naturalhazardscience/groundlark/hw/burrowlark-usb/boards/groundlark-field-head/preview/groundlark-field-head-01-usb-power-page-01.png

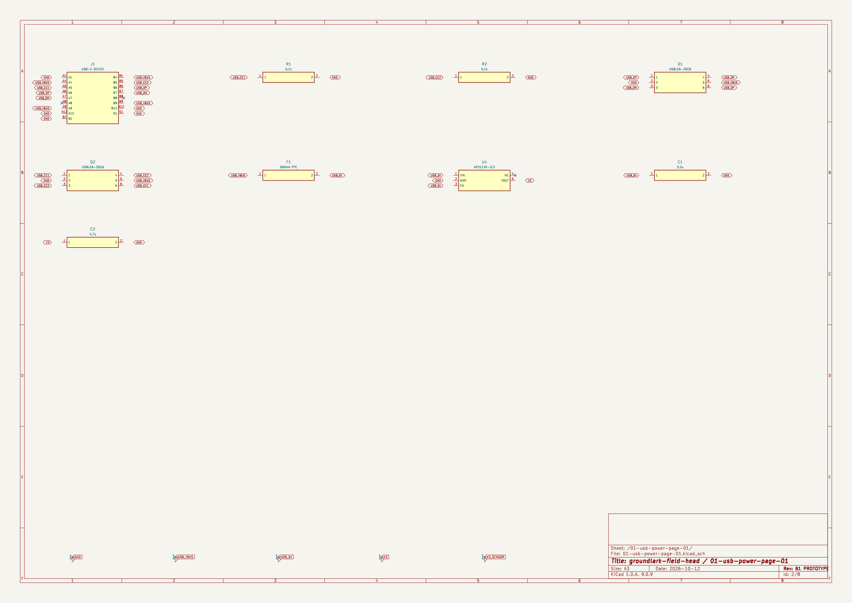
hw/burrowlark-usb/boards/groundlark-field-head/preview/groundlark-field-head-01-usb-power-page-01.png
