naturalhazardscience/groundlark/hw/burrowlark-usb/boards/groundlark-field-head/preview/groundlark-field-head-02-controller-page-01.png

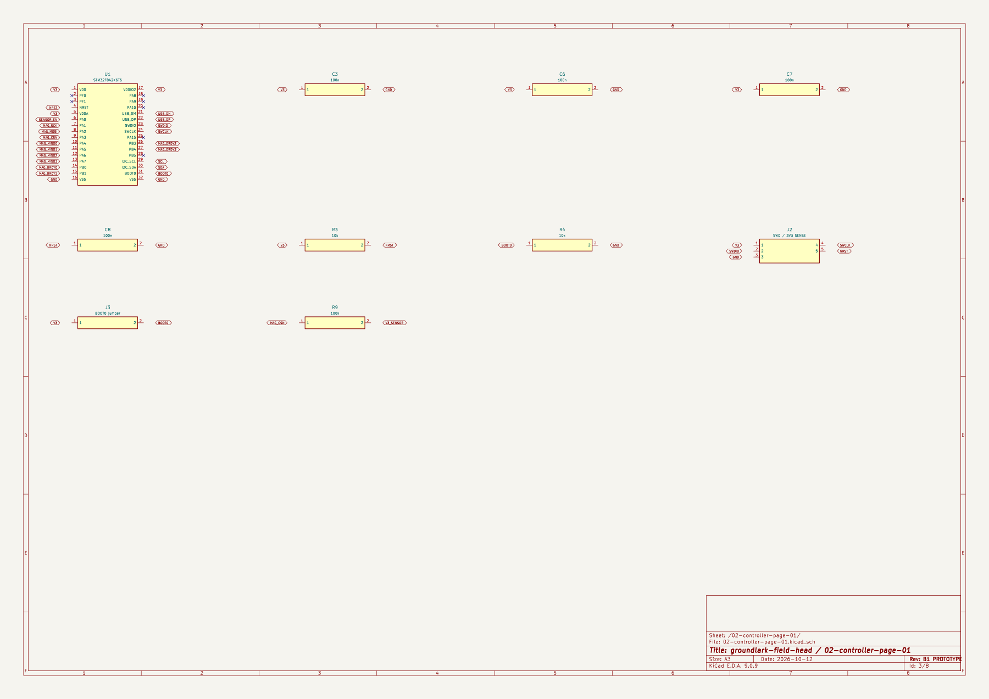
hw/burrowlark-usb/boards/groundlark-field-head/preview/groundlark-field-head-02-controller-page-01.png
