naturalhazardscience/groundlark/hw/burrowlark-usb/boards/groundlark-field-head/preview/groundlark-field-head-03-magnetometer-0-page-01.png

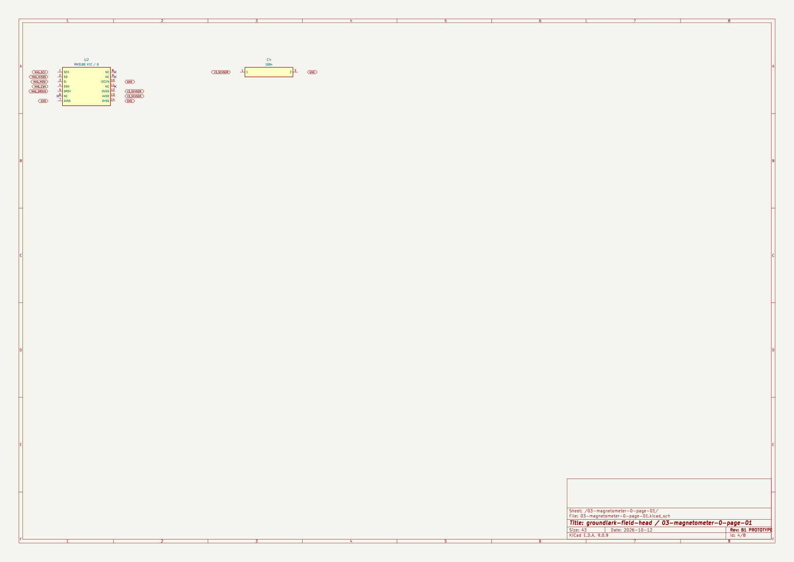
hw/burrowlark-usb/boards/groundlark-field-head/preview/groundlark-field-head-03-magnetometer-0-page-01.png
