naturalhazardscience/groundlark/hw/burrowlark-usb/boards/groundlark-field-head/preview/groundlark-field-head.png

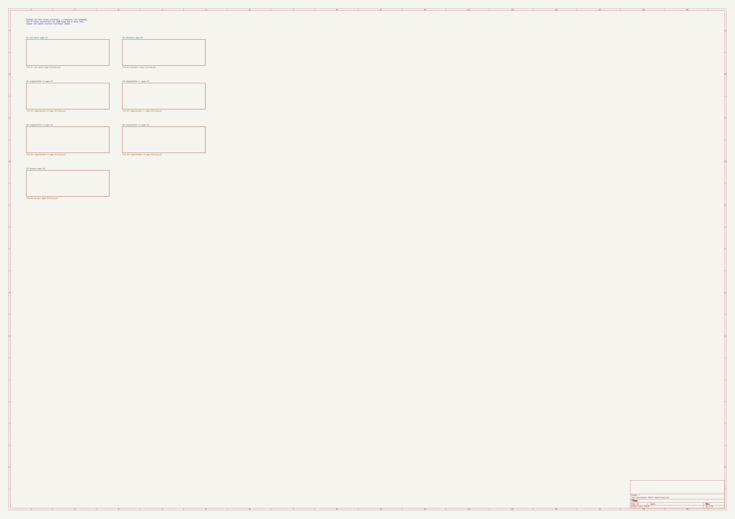
hw/burrowlark-usb/boards/groundlark-field-head/preview/groundlark-field-head.png
