naturalhazardscience/groundlark/hw/burrowlark-usb/boards/groundlark-field-head/preview/layout.png

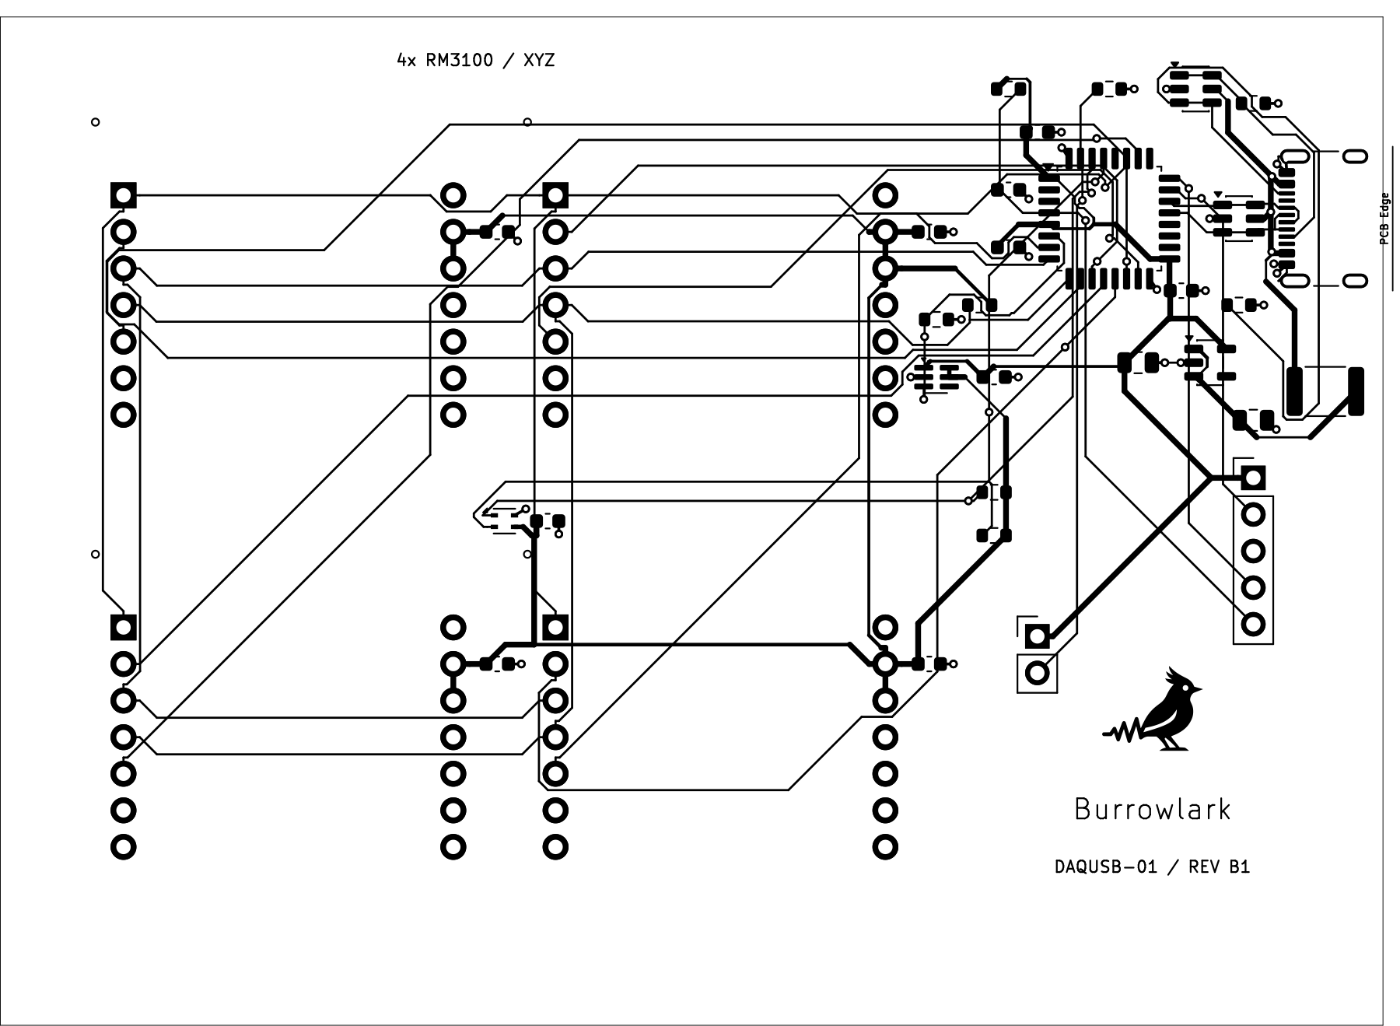
hw/burrowlark-usb/boards/groundlark-field-head/preview/layout.png
