naturalhazardscience/groundlark/hw/groundlark-fpga-hat/boards/groundlark-daqhat-01/3d-bottom.png

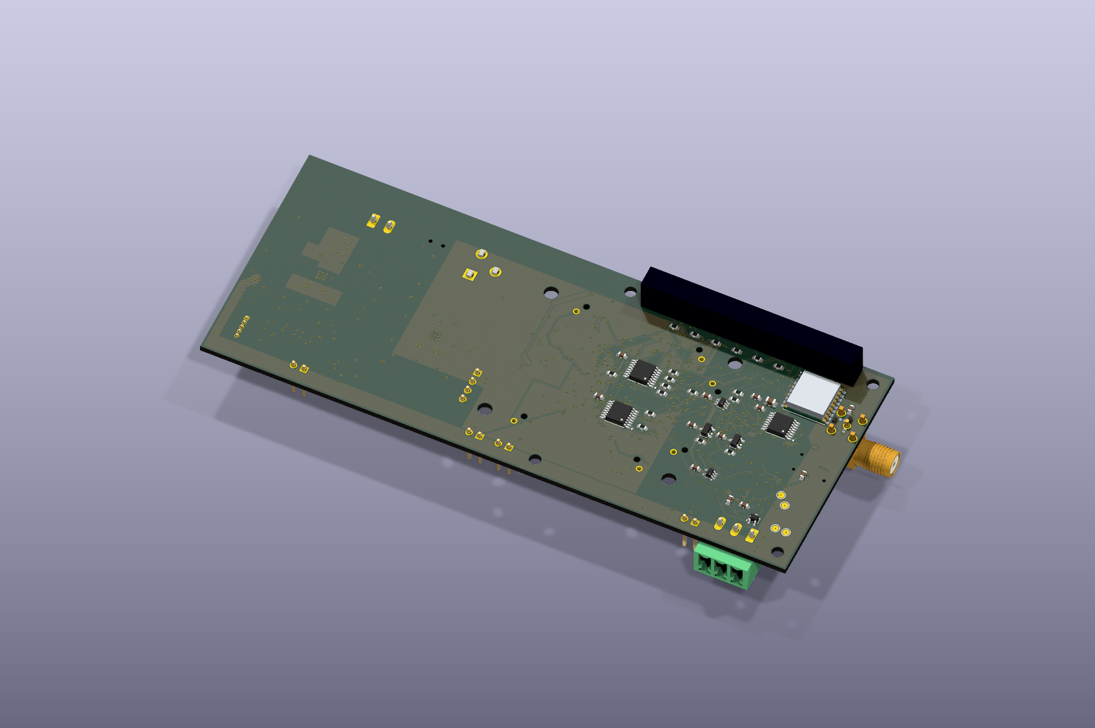
hw/groundlark-fpga-hat/boards/groundlark-daqhat-01/3d-bottom.png
