naturalhazardscience/groundlark/hw/groundlark-fpga-hat/boards/groundlark-daqhat-01/3d.png

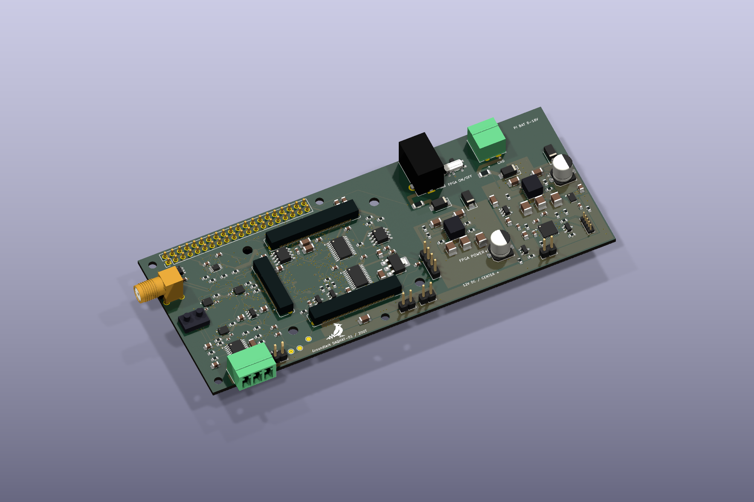
hw/groundlark-fpga-hat/boards/groundlark-daqhat-01/3d.png
