naturalhazardscience/groundlark/hw/groundlark-fpga-hat/boards/groundlark-daqhat-01/pi-trenz-stack-concept.png

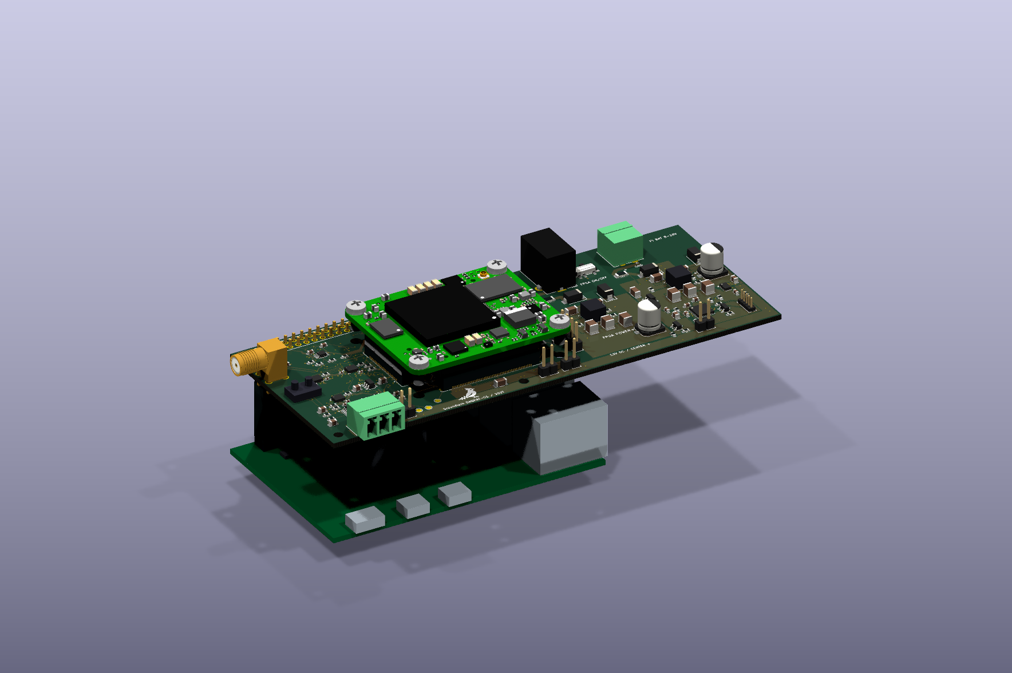
hw/groundlark-fpga-hat/boards/groundlark-daqhat-01/pi-trenz-stack-concept.png
