naturalhazardscience/groundlark/hw/groundlark-fpga-hat/boards/groundlark-daqhat-01/stack-exploded.png

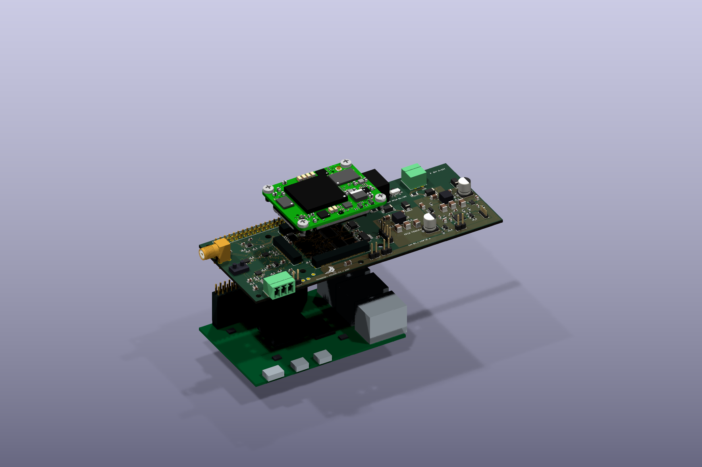
hw/groundlark-fpga-hat/boards/groundlark-daqhat-01/stack-exploded.png
