naturalhazardscience/groundlark/hw/groundlark-fpga-hat/boards/groundlark-daqhat-01/stack-service-envelopes.png

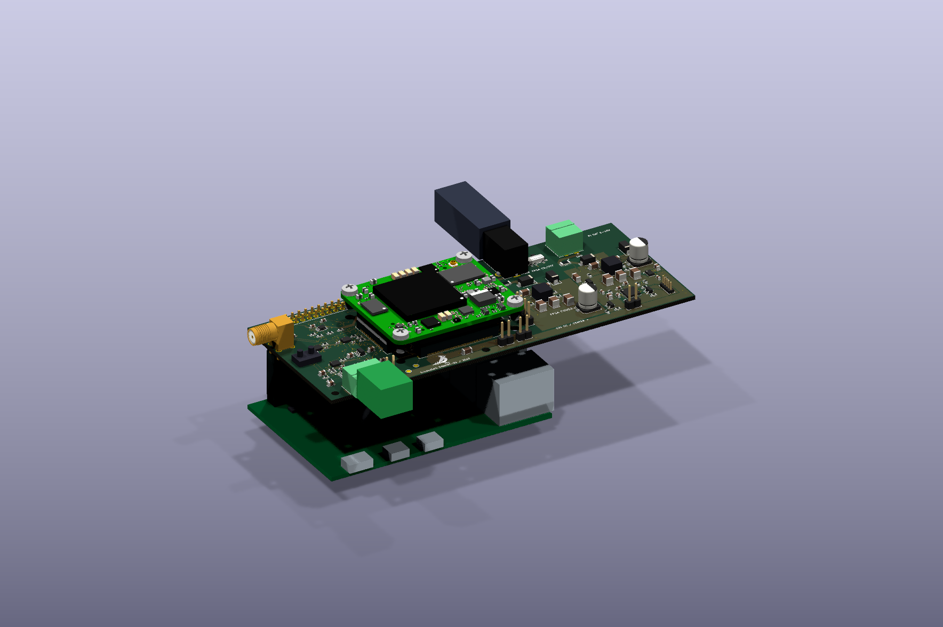
hw/groundlark-fpga-hat/boards/groundlark-daqhat-01/stack-service-envelopes.png
