naturalhazardscience/groundlark/hw/groundlark-fpga-hat/boards/groundlark-daqhat-01/trenz-mounted.png

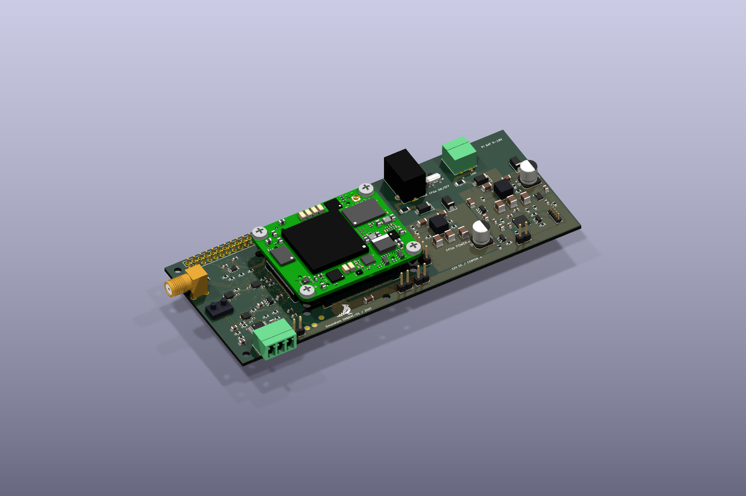
hw/groundlark-fpga-hat/boards/groundlark-daqhat-01/trenz-mounted.png
