naturalhazardscience/groundlark/hw/groundlark-fpga-hat/boards/groundlark-daqhat-01/bom.csv

Reference | Value | MPN | Footprint | DNP | Note
J1 | Raspberry Pi 40-pin | Samtec ESQ-120-23-G-D | Connector_PinHeader_2.54mm__PinHeader_2x20_P2.54mm_Vertical | False | Header land pattern matches bottom mounted socket top-view numbering; tall stack, check Pi 4/5 cooler clearance.
U1 | 24LC32A | 24LC32A-I/SN | Package_SO__SOIC-8_3.9x4.9mm_P1.27mm | False
R1 | 3.9k | RC0603FR-073K9L | Resistor_SMD__R_0603_1608Metric | False
R2 | 3.9k | RC0603FR-073K9L | Resistor_SMD__R_0603_1608Metric | False
R3 | 1k | RC0603FR-071KL | Resistor_SMD__R_0603_1608Metric | False
JP1 | EEPROM write enable | EEPROM write enable | Connector_PinHeader_2.54mm__PinHeader_1x02_P2.54mm_Vertical | False | Fit shunt only while programming ID EEPROM.
C1 | 100n | GRM188R71H104KA93D | Capacitor_SMD__C_0603_1608Metric | False
C2 | 10u | GRM21BR61A106KE19L | Capacitor_SMD__C_0805_2012Metric | False
C3 | 10u | GRM21BR61A106KE19L | Capacitor_SMD__C_0805_2012Metric | False
U11 | LSM6DSOTR | LSM6DSOTR | Package_LGA__LGA-14_3x2.5mm_P0.5mm_LayoutBorder3x4y | False
C12 | 100n | GRM155R71C104KA88D | Capacitor_SMD__C_0402_1005Metric | False
C13 | 100n | GRM155R71C104KA88D | Capacitor_SMD__C_0402_1005Metric | False
R11 | 10k | RC0603FR-0710KL | Resistor_SMD__R_0603_1608Metric | False
U12 | LSM6DSOTR | LSM6DSOTR | Package_LGA__LGA-14_3x2.5mm_P0.5mm_LayoutBorder3x4y | False
C14 | 100n | GRM155R71C104KA88D | Capacitor_SMD__C_0402_1005Metric | False
C15 | 100n | GRM155R71C104KA88D | Capacitor_SMD__C_0402_1005Metric | False
R12 | 10k | RC0603FR-0710KL | Resistor_SMD__R_0603_1608Metric | False
U13 | LSM6DSOTR | LSM6DSOTR | Package_LGA__LGA-14_3x2.5mm_P0.5mm_LayoutBorder3x4y | False
C16 | 100n | GRM155R71C104KA88D | Capacitor_SMD__C_0402_1005Metric | False
C17 | 100n | GRM155R71C104KA88D | Capacitor_SMD__C_0402_1005Metric | False
R13 | 10k | RC0603FR-0710KL | Resistor_SMD__R_0603_1608Metric | False
J4 | FPGA test UART/reset | FPGA UART service ONLY | Connector_PinHeader_2.54mm__PinHeader_1x04_P2.54mm_Vertical | False | Test points for assembled module UART and active-low reset; do not connect a second driving host.
H1 | M2.5 NPTH | M2.5 NPTH | MountingHole__MountingHole_2.7mm_M2.5 | False | Nonmagnetic standoffs.
H2 | M2.5 NPTH | M2.5 NPTH | MountingHole__MountingHole_2.7mm_M2.5 | False | Nonmagnetic standoffs.
H3 | M2.5 NPTH | M2.5 NPTH | MountingHole__MountingHole_2.7mm_M2.5 | False | Nonmagnetic standoffs.
H4 | M2.5 NPTH | M2.5 NPTH | MountingHole__MountingHole_2.7mm_M2.5 | False | Nonmagnetic standoffs.
U40 | TLV1117LV33DCYR | TLV1117LV33DCYR | Package_TO_SOT_SMD__SOT-223-3_TabPin2 | False
C40 | 10u | GRM21BR61A106KE19L | Capacitor_SMD__C_0805_2012Metric | False
C41 | 100n | GRM188R71H104KA93D | Capacitor_SMD__C_0603_1608Metric | False
C42 | 22u | GRM31CR61A226KE19L | Capacitor_SMD__C_1206_3216Metric | False
C43 | 100n | GRM188R71H104KA93D | Capacitor_SMD__C_0603_1608Metric | False
U41 | SN74LVC8T245PWR | SN74LVC8T245PWR | Package_SO__TSSOP-24_4.4x7.8mm_P0.65mm | False
U42 | SN74LVC8T245PWR | SN74LVC8T245PWR | Package_SO__TSSOP-24_4.4x7.8mm_P0.65mm | False
C44 | 100n | GRM188R71H104KA93D | Capacitor_SMD__C_0603_1608Metric | False
C45 | 100n | GRM188R71H104KA93D | Capacitor_SMD__C_0603_1608Metric | False
C46 | 100n | GRM188R71H104KA93D | Capacitor_SMD__C_0603_1608Metric | False
C47 | 100n | GRM188R71H104KA93D | Capacitor_SMD__C_0603_1608Metric | False
R50 | 10k | RC0603FR-0710KL | Resistor_SMD__R_0603_1608Metric | False
R51 | 100k | RC0603FR-07100KL | Resistor_SMD__R_0603_1608Metric | False
U43 | ISO1640BDR | ISO1640BDR | Package_SO__SOIC-8_3.9x4.9mm_P1.27mm | False | Power-domain isolation only: grounds are joined. Side-1 VOL max 0.71V requires host VIL >=0.8V; verify Pi revision.
C48 | 100n | GRM188R71H104KA93D | Capacitor_SMD__C_0603_1608Metric | False
C49 | 100n | GRM188R71H104KA93D | Capacitor_SMD__C_0603_1608Metric | False
R52 | 4.7k | RC0603FR-074K7L | Resistor_SMD__R_0603_1608Metric | False
R53 | 4.7k | RC0603FR-074K7L | Resistor_SMD__R_0603_1608Metric | False
TP1 | SENS_3V3 | SENS_3V3 | TestPoint__TestPoint_Pad_D1.5mm | False
TP2 | GND | GND | TestPoint__TestPoint_Pad_D1.5mm | False
TP4 | SENSOR_OE_N | SENSOR_OE_N | TestPoint__TestPoint_Pad_D1.5mm | False
U51 | TXU0202DCUR | TXU0202DCUR | Package_SO__VSSOP-8_2.3x2mm_P0.5mm | False
C75 | 100n | GRM188R71H104KA93D | Capacitor_SMD__C_0603_1608Metric | False
C76 | 100n | GRM188R71H104KA93D | Capacitor_SMD__C_0603_1608Metric | False
R61 | 47 | RC0603FR-0747RL | Resistor_SMD__R_0603_1608Metric | False
R62 | 100k | RC0603FR-07100KL | Resistor_SMD__R_0603_1608Metric | False
R63 | 10k | RC0603FR-0710KL | Resistor_SMD__R_0603_1608Metric | False
U52 | TLV803EA30DBZR | TLV803EA30DBZR | Package_TO_SOT_SMD__SOT-23 | False | 3.0V falling threshold, 200ms nominal release delay; open-drain output.
C77 | 100n | GRM188R71H104KA93D | Capacitor_SMD__C_0603_1608Metric | False
R64 | 10k | RC0603FR-0710KL | Resistor_SMD__R_0603_1608Metric | False
Q1 | 2N7002 | 2N7002 | Package_TO_SOT_SMD__SOT-23 | False | Pi GPIO17 HIGH asserts chip reset; does not drive a live voltage into unpowered chip.
R65 | 1k | RC0603FR-071KL | Resistor_SMD__R_0603_1608Metric | False
R66 | 100k | RC0603FR-07100KL | Resistor_SMD__R_0603_1608Metric | False
J80 | LSHM-150-04.0-L-DV-A-S-K-TR | LSHM-150-04.0-L-DV-A-S-K-TR | TZ_TZ100 | False | Mates JM1; opposite parity; 8 mm board surface gap
J81 | LSHM-150-04.0-L-DV-A-S-K-TR | LSHM-150-04.0-L-DV-A-S-K-TR | TZ_TZ100 | False | Mates JM2; opposite parity; 8 mm board surface gap
J82 | LSHM-130-04.0-L-DV-A-S-K-TR | LSHM-130-04.0-L-DV-A-S-K-TR | TZ_TZ60 | False | Mates JM3; opposite parity; 8 mm board surface gap
JP80 | TSW-102-07-G-S | TSW-102-07-G-S | TZ_TZ_JP | False | Fit shunt to DISABLE module; open enables on-board sequence
JP81 | TSW-102-07-G-S | TSW-102-07-G-S | TZ_TZ_JP | False | Fit shunt to request module configuration reset
R80 | 10k | RC0603FR-0710KL | Resistor_SMD__R_0603_1608Metric | False | FPGA JTAG selection / spare CPLD control idle pull-down
R81 | 10k | RC0603FR-0710KL | Resistor_SMD__R_0603_1608Metric | False | FPGA JTAG selection / spare CPLD control idle pull-down
C80 | 22u | GRM31CR61A226KE19L | Capacitor_SMD__C_1206_3216Metric | False | Carrier local decoupling; module contains core decoupling
C81 | 22u | GRM31CR61A226KE19L | Capacitor_SMD__C_1206_3216Metric | False | Carrier local decoupling; module contains core decoupling
C82 | 22u | GRM31CR61A226KE19L | Capacitor_SMD__C_1206_3216Metric | False | Carrier local decoupling; module contains core decoupling
C83 | 100n | GRM188R71H104KA93D | Capacitor_SMD__C_0603_1608Metric | False | Carrier local decoupling; module contains core decoupling
C84 | 4.7u | GRM21BR71A475KA73L | Capacitor_SMD__C_0805_2012Metric | False | Carrier local decoupling; module contains core decoupling
C85 | 4.7u | GRM21BR71A475KA73L | Capacitor_SMD__C_0805_2012Metric | False | Carrier local decoupling; module contains core decoupling
H80 | M3 / 8 mm spacer | M3 / 8 mm spacer | TZ_TZ_HOLE | False
H81 | M3 / 8 mm spacer | M3 / 8 mm spacer | TZ_TZ_HOLE | False
H82 | M3 / 8 mm spacer | M3 / 8 mm spacer | TZ_TZ_HOLE | False
H83 | M3 / 8 mm spacer | M3 / 8 mm spacer | TZ_TZ_HOLE | False
U22 | ADS122C04 | ADS122C04IPWR | Package_SO__TSSOP-16_4.4x5mm_P0.65mm | False | I2C 0x40; internal 2.048V reference, gain 64, normal 330 SPS; unused analog/reference inputs open per TI.
J90 | GEO + / - / SHIELD | 1803280 | Connector_Phoenix_MC__PhoenixContact_MC_1,5_3-G-3.81_1x03_P3.81mm_Horizontal | False | Horizontal outward entry (+Y). 1 positive, 2 negative, 3 cable shield. Mate Phoenix 1803581. Never connect power.
D90 | TPD2E2U06 | TPD2E2U06QDCKRQ1 | Package_TO_SOT_SMD__SOT-323_SC-70 | False | Connector ESD suppression only; not lightning protection.
R90 | 1k | RC0603FR-071KL | Resistor_SMD__R_0603_1608Metric | False | Matched series input filter / current limiting.
R91 | 1k | RC0603FR-071KL | Resistor_SMD__R_0603_1608Metric | False
C90 | 100n C0G | C3216C0G1H104J160AA | Capacitor_SMD__C_1206_3216Metric | False | C0G differential filter; no piezoelectric X7R on signal path.
C91 | 1n C0G | C0603C102J5GACTU | Capacitor_SMD__C_0603_1608Metric | False
C92 | 1n C0G | C0603C102J5GACTU | Capacitor_SMD__C_0603_1608Metric | False
R92 | 1M | RC0603FR-071ML | Resistor_SMD__R_0603_1608Metric | False
R93 | 1M | RC0603FR-071ML | Resistor_SMD__R_0603_1608Metric | False
R94 | 10k | RC0603FR-0710KL | Resistor_SMD__R_0603_1608Metric | False
R95 | 10k | RC0603FR-0710KL | Resistor_SMD__R_0603_1608Metric | False
C93 | 10u | GRM21BR61A106KE19L | Capacitor_SMD__C_0805_2012Metric | False | Filtered mid-supply; sensor has no excitation current source.
R96 | 22 | RC0603FR-0722RL | Resistor_SMD__R_0603_1608Metric | False
C94 | 10u | GRM21BR61A106KE19L | Capacitor_SMD__C_0805_2012Metric | False
C95 | 100n | GRM188R71H104KA93D | Capacitor_SMD__C_0603_1608Metric | False
C96 | 100n | GRM188R71H104KA93D | Capacitor_SMD__C_0603_1608Metric | False
R97 | 10k | RC0603FR-0710KL | Resistor_SMD__R_0603_1608Metric | False | Open-drain DRDY pullup; existing U42 return buffer to BCM4.
U100 | TMUX1574PWR | TMUX1574PWR | Package_SO__TSSOP-16_4.4x5mm_P0.65mm | False | SEL=0 application, SEL=1 native JTAG; EN high isolates; FPGA-powered with power-off protection.
U101 | TMUX1574PWR | TMUX1574PWR | Package_SO__TSSOP-16_4.4x5mm_P0.65mm | False | S1B/S2B deliberately open parking paths: isolate CS/DQ3 in JTAG. Unused complete channels grounded.
U102 | TCA9534PWR | TCA9534PWR | Package_SO__TSSOP-16_4.4x5mm_P0.65mm | False | I2C 0x20. Write output 0 before config 0xFC. P2-P7 remain grounded inputs; INT unused. Pi header supplies I2C pullups.
U103 | SN74LVC1G10DCKR | SN74LVC1G10DCKR | Package_TO_SOT_SMD__SOT-363_SC-70-6 | False | Disable unless request AND both independent rail supervisors are high; inputs tolerate an unpowered gate.
U104 | TLV809EA30DBZR | TLV809EA30DBZR | Package_TO_SOT_SMD__SOT-23 | False | 3.0 V threshold, 200 ms nominal release, push-pull. Separate from application reset.
U105 | TLV809EA30DBZR | TLV809EA30DBZR | Package_TO_SOT_SMD__SOT-23 | False | 3.0 V threshold, 200 ms nominal release, push-pull. Separate from application reset.
C100 | 100n | GRM188R71H104KA93D | Capacitor_SMD__C_0603_1608Metric | False
C101 | 100n | GRM188R71H104KA93D | Capacitor_SMD__C_0603_1608Metric | False
C102 | 100n | GRM188R71H104KA93D | Capacitor_SMD__C_0603_1608Metric | False
C103 | 100n | GRM188R71H104KA93D | Capacitor_SMD__C_0603_1608Metric | False
C104 | 100n | GRM188R71H104KA93D | Capacitor_SMD__C_0603_1608Metric | False
C105 | 100n | GRM188R71H104KA93D | Capacitor_SMD__C_0603_1608Metric | False
R100 | 22 | RC0603FR-0722RL | Resistor_SMD__R_0603_1608Metric | False | 22 ohm series damping; quad data paths are bidirectional. Qualify maximum clock on hardware.
R101 | 22 | RC0603FR-0722RL | Resistor_SMD__R_0603_1608Metric | False | 22 ohm series damping; quad data paths are bidirectional. Qualify maximum clock on hardware.
R102 | 22 | RC0603FR-0722RL | Resistor_SMD__R_0603_1608Metric | False | 22 ohm series damping; quad data paths are bidirectional. Qualify maximum clock on hardware.
R103 | 22 | RC0603FR-0722RL | Resistor_SMD__R_0603_1608Metric | False | 22 ohm series damping; quad data paths are bidirectional. Qualify maximum clock on hardware.
R104 | 22 | RC0603FR-0722RL | Resistor_SMD__R_0603_1608Metric | False | 22 ohm series damping; quad data paths are bidirectional. Qualify maximum clock on hardware.
R105 | 22 | RC0603FR-0722RL | Resistor_SMD__R_0603_1608Metric | False | 22 ohm series damping; quad data paths are bidirectional. Qualify maximum clock on hardware.
R106 | 10k | RC0603FR-0710KL | Resistor_SMD__R_0603_1608Metric | False
R107 | 10k | RC0603FR-0710KL | Resistor_SMD__R_0603_1608Metric | False
R108 | 10k | RC0603FR-0710KL | Resistor_SMD__R_0603_1608Metric | False
R109 | 10k | RC0603FR-0710KL | Resistor_SMD__R_0603_1608Metric | False
R110 | 10k | RC0603FR-0710KL | Resistor_SMD__R_0603_1608Metric | False
R111 | 10k | RC0603FR-0710KL | Resistor_SMD__R_0603_1608Metric | False
R112 | 100k | RC0603FR-07100KL | Resistor_SMD__R_0603_1608Metric | False
R113 | 10k | RC0603FR-0710KL | Resistor_SMD__R_0603_1608Metric | False
R114 | 100k | RC0603FR-07100KL | Resistor_SMD__R_0603_1608Metric | False
R115 | 10k | RC0603FR-0710KL | Resistor_SMD__R_0603_1608Metric | False
R116 | 100k | RC0603FR-07100KL | Resistor_SMD__R_0603_1608Metric | False
R117 | 100k | RC0603FR-07100KL | Resistor_SMD__R_0603_1608Metric | False
U106 | SN74LVC1G08DCKR | SN74LVC1G08DCKR | Package_TO_SOT_SMD__SOT-353_SC-70-5 | False | Existing BCM25 FPGA_IO_ENABLE is also a hardware disarm independent of I2C. Default-low R62 retained.
C106 | 100n | GRM188R71H104KA93D | Capacitor_SMD__C_0603_1608Metric | False
U23 | SDP32-125PA | SDP32-125PA-TR-250PCS | Groundlark__SDP32 | False | SDP32 +/-125 Pa; 3.3 V I2C 0x21; one final reflow only; no board wash; pneumatic qualification pending.
C24 | 100n | GRM188R71H104KA93D | Capacitor_SMD__C_0603_1608Metric | False | Local SDP32 supply bypass beneath supply escape
J83 | 12V DC / CENTER + | PJ-102AH | PWR_BarrelJack_CUI_PJ-102AH_Horizontal | False | 5.5/2.1 mm mating plug; mouth faces -Y, opposite J90 +Y; sleeve switch pin 3 NC
F80 | 0466002.NRHF | 0466002.NRHF | PWR_Fuse_1206_3216Metric | False | Input fuse; output current controlled by buck converter
D80 | B340A | B340A-13-F | PWR_D_SMA | False | 3 A / 40 V Schottky; reverse-polarity series protection
D81 | SMAJ15A | SMAJ15A-13-F | PWR_D_SMA | False | 15 V standoff TVS; transient suppression, not sustained overvoltage cutoff
U80 | TPSM53603 | TPSM53603RDAR | PWR_Texas_B3QFN-14-1EP_5x5.5mm_P0.65mm | False | Pins 4/5 DNC isolated; pin13 V5V NC; 3 A envelope, thermal qualification pending
R120 | 10k | RT0603BRD0710KL | PWR_R_0603_1608Metric | False | 0.1% feedback upper
R121 | 4.30k | RT0603BRD074K3L | PWR_R_0603_1608Metric | False | 0.1% feedback lower; nominal 3.32558 V
R122 | 100k | RC0603FR-07100KL | PWR_R_0603_1608Metric | False | UVLO upper
R123 | 15k | RC0603FR-0715KL | PWR_R_0603_1608Metric | False | UVLO lower
R124 | 10k | RT0603BRD0710KL | PWR_R_0603_1608Metric | False | Power-good pullup; module sequencing inhibited until converter PGOOD
SW80 | FPGA OFF / ON | PCM12SMTR | PWR_SW_SPDT_PCM12 | False | OFF grounds converter EN; ON leaves divider active; no Pi required
C86 | 10u | CGA5L1X7R1H106K160AC | PWR_C_1206_3216Metric | False | 50 V X7R 1206; TI recommended input capacitor
C87 | 10u | CGA5L1X7R1H106K160AC | PWR_C_1206_3216Metric | False | 50 V X7R 1206; TI recommended input capacitor
C88 | 100n | GRM188R71H104KA93D | PWR_C_0603_1608Metric | False | 50 V ceramic input bypass
C89 | 47u | EEE-FK1V470P | PWR_CP_Elec_6.3x7.7 | False | 35 V aluminum input bulk; observe polarity
C110 | 22u | GRM32ER71E226KE15L | PWR_C_1210_3225Metric | False | 25 V X7R 1210; three local caps must provide >=43 uF effective combined
C111 | 22u | GRM32ER71E226KE15L | PWR_C_1210_3225Metric | False | 25 V X7R 1210; three local caps must provide >=43 uF effective combined
C112 | 22u | GRM32ER71E226KE15L | PWR_C_1210_3225Metric | False | 25 V X7R 1210; three local caps must provide >=43 uF effective combined
J130 | PI BATTERY 8-18V | 1803277 | SUP_PhoenixContact_MC_1,5_2-G-3.81_1x02_P3.81mm_Horizontal | False | External protected battery/controller DC output; no solar panel or charging input
F130 | 4A fuse | 0466004.NRHF | SUP_Fuse_1206_3216Metric | False
D130 | B340A | B340A-13-F | PWR_D_SMA | False
D131 | SMAJ18A | SMAJ18A-13-F | SUP_D_SMA | False
U131 | TPS70933 | TPS70933DBVR | SUP_SOT-23-5 | False | Always on; EN internally biased, never connect EN to raw battery
C130 | 4.7u | GRM21BR71C475KA73L | SUP_C_0805_2012Metric | False | At least 2.2uF effective at 3.3V
C131 | 10u | CGA5L1X7R1H106K160AC | PWR_C_1206_3216Metric | False
U132 | TPSM53603 | TPSM53603RDAR | PWR_Texas_B3QFN-14-1EP_5x5.5mm_P0.65mm | False | 5.149V / 3A total Pi+HAT allocation; EN pulldown gives default OFF
C132 | 10u | CGA5L1X7R1H106K160AC | PWR_C_1206_3216Metric | False
C133 | 10u | CGA5L1X7R1H106K160AC | PWR_C_1206_3216Metric | False
C134 | 100n | GRM188R71H104KA93D | PWR_C_0603_1608Metric | False
C135 | 47u | EEE-FK1V470P | PWR_CP_Elec_6.3x7.7 | False
C136 | 22u | GRM32ER71E226KE15L | PWR_C_1210_3225Metric | False | Combined effective capacitance must be at least 44uF at 5.15V
C137 | 22u | GRM32ER71E226KE15L | PWR_C_1210_3225Metric | False | Combined effective capacitance must be at least 44uF at 5.15V
C138 | 22u | GRM32ER71E226KE15L | PWR_C_1210_3225Metric | False | Combined effective capacitance must be at least 44uF at 5.15V
R130 | 10k | RT0603BRD0710KL | PWR_R_0603_1608Metric | False
R131 | 2.43k | RT0603BRD072K43L | SUP_R_0603_1608Metric | False
R132 | 100k | RC0603FR-07100KL | PWR_R_0603_1608Metric | False
U133 | TPS22953 | TPS22953DQCR | SUP_Texas_WSON10_DQC0010A | False | Reverse blocking while disabled; no simultaneous Pi USB-C supply
C139 | 10n | GRM188R71H103KA01D | SUP_C_0603_1608Metric | False | 50V slew capacitor; approximately 18ms output rise
C140 | 10u | GRM21BR61C106KE15L | SUP_C_0805_2012Metric | False
R133 | 2k | RC0603FR-072KL | SUP_R_0603_1608Metric | False | Output bleed; minimum OFF time must be qualified with actual Pi capacitance
U130 | MSPM0L1106 | MSPM0L1106TRHBR | SUP_QFN-32-1EP_5x5mm_P0.5mm_EP3.45x3.45mm | False | 32k flash / 4k RAM. Internal clock; unused GPIO disabled in firmware. No external VCORE load.
C141 | 100n | GRM188R71H104KA93D | PWR_C_0603_1608Metric | False
C142 | 10u | GRM21BR61C106KE15L | SUP_C_0805_2012Metric | False
C143 | 470n | GRM188R71C474KA88D | SUP_C_0603_1608Metric | False
R134 | 47k | RC0603FR-0747KL | SUP_R_0603_1608Metric | False
C144 | 10n | GRM188R71H103KA01D | SUP_C_0603_1608Metric | False
R135 | 1M | RT0603BRD071ML | SUP_R_0603_1608Metric | False
R136 | 150k | RT0603BRD07150KL | SUP_R_0603_1608Metric | False
C145 | 10n | GRM188R71H103KA01D | SUP_C_0603_1608Metric | False
Q130 | 2N7002 | 2N7002,215 | SUP_SOT-23 | False
R137 | 100k | RC0603FR-07100KL | PWR_R_0603_1608Metric | False
R138 | 10k | RT0603BRD0710KL | PWR_R_0603_1608Metric | False
Q131 | 2N7002 | 2N7002,215 | SUP_SOT-23 | False
R139 | 100k | RC0603FR-07100KL | PWR_R_0603_1608Metric | False
R140 | 100k | RC0603FR-07100KL | PWR_R_0603_1608Metric | False
J131 | SWD / 3V3 REF | FTS-105-01-L-S | SUP_PinHeader_1x05_P1.27mm_Vertical | False | Probe voltage reference only; do not power target through header
JP130 | BENCH RUN | TSW-102-07-G-S | SUP_PinHeader_1x02_P2.54mm_Vertical | False | Open for supervised operation. Shunt is a manual run override with unprogrammed MCU; remove before firmware controls RUN.
R141 | 10k | RT0603BRD0710KL | PWR_R_0603_1608Metric | False | Limits MCU pin current if bench shunt is left fitted; remove shunt for automatic power control
TP90 | GND | PCB copper | TestPoint__TestPoint_Pad_D1.5mm | True | Calibration probe pad; no fitted component. Use high impedance probe.
TP91 | GEO_VCM | PCB copper | TestPoint__TestPoint_Pad_D1.5mm | True | Calibration probe pad; no fitted component. Use high impedance probe.
TP92 | GEO_AVDD | PCB copper | TestPoint__TestPoint_Pad_D1.5mm | True | Calibration probe pad; no fitted component. Use high impedance probe.
TP93 | GEO_DRDY_N | PCB copper | TestPoint__TestPoint_Pad_D1.5mm | True | Calibration probe pad; no fitted component. Use high impedance probe.
U21 | MAX-M10S-00B | MAX-M10S-00B | RF_GPS__ublox_MAX | False | u-blox; JLCPCB C4153167. I2C 0x42; PPS BCM24. No backup supply.
J140 | GNSS ANT / 3V3 | HL-SMA-KWE-02 | GNSS_HL_SMA_KWE_02 | False | HenryTech C20617216; female SMA 50 ohm; axis native -X. Active antenna 3.3V <=20mA. Not RP-SMA.
C146 | 4.7u | GRM21BR71C475KA73L | Capacitor_SMD__C_0805_2012Metric | False
C147 | 100n | GRM188R71H104KA93D | Capacitor_SMD__C_0603_1608Metric | False
C148 | 47p C0G | GRM1555C1H470JA01D | GNSS_C0402 | False
L140 | 56n | 0402HPH-56NXJRW | GNSS_HP0402 | False | Coilcraft 56 nH bias choke; short B.Cu branch and local C151 bypass.
U140 | TPS70933 | TPS70933DBVR | SUP_SOT-23-5 | False | 3.3 V antenna LDO; downstream U141 limits sustained shorts to 100 mA maximum. 20 mA antenna allocation.
C149 | 4.7u | GRM21BR71C475KA73L | Capacitor_SMD__C_0805_2012Metric | False
C150 | 4.7u | GRM21BR71C475KA73L | Capacitor_SMD__C_0805_2012Metric | False
D140 | PESD5V0F1BL | PESD5V0F1BL,315 | GNSS_SOD882 | False | Bidirectional low-capacitance ESD diode; short RF branch and local ground stitch.
U141 | TPS2553 | TPS2553DBVR | GNSS_SOT23_6 | False | TI DBV pin table: 1 IN, 2 GND, 3 EN, 4 FAULT NC, 5 ILIM tied IN, 6 OUT. 50..100 mA limit.
C151 | 10n | GRM188R71H103KA01D | SUP_C_0603_1608Metric | False | Local RF bypass at L140 cold end; short ground stitch.
C152 | 100n | GRM188R71H104KA93D | Capacitor_SMD__C_0603_1608Metric | False | U141 input bypass.
R118 | 10k | RC0603FR-0710KL | Resistor_SMD__R_0603_1608Metric | False | Pi UART RX idle pull-up while U51 is disabled
L141 | 3.6n | 0402HP-3N6XJRW | GNSS_HP0402 | False | Series RF matching inductor; retain C148 DC block.
