naturalhazardscience/groundlark/hw/shared/models/Coilcraft_0402HP_envelope.step

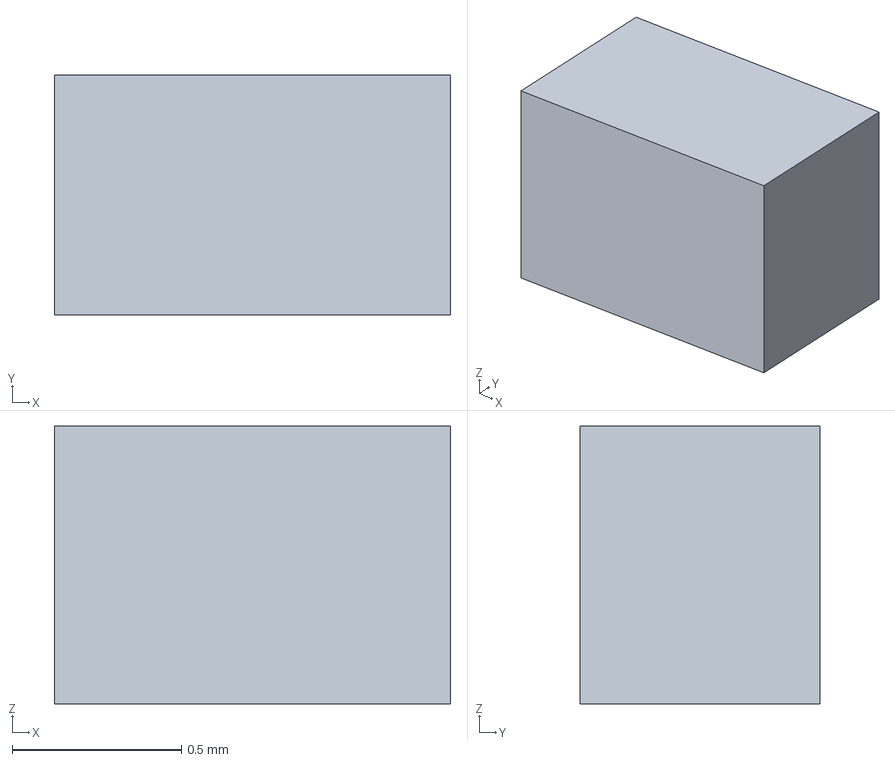
[picture p14: CAD file, 2026-10-20]
hw/shared/models/Coilcraft_0402HP_envelope.step
1.17 x 0.71 x 0.82 mm
