naturalhazardscience/groundlark/hw/burrowlark-usb/boards/groundlark-field-head/preview/assembly.png

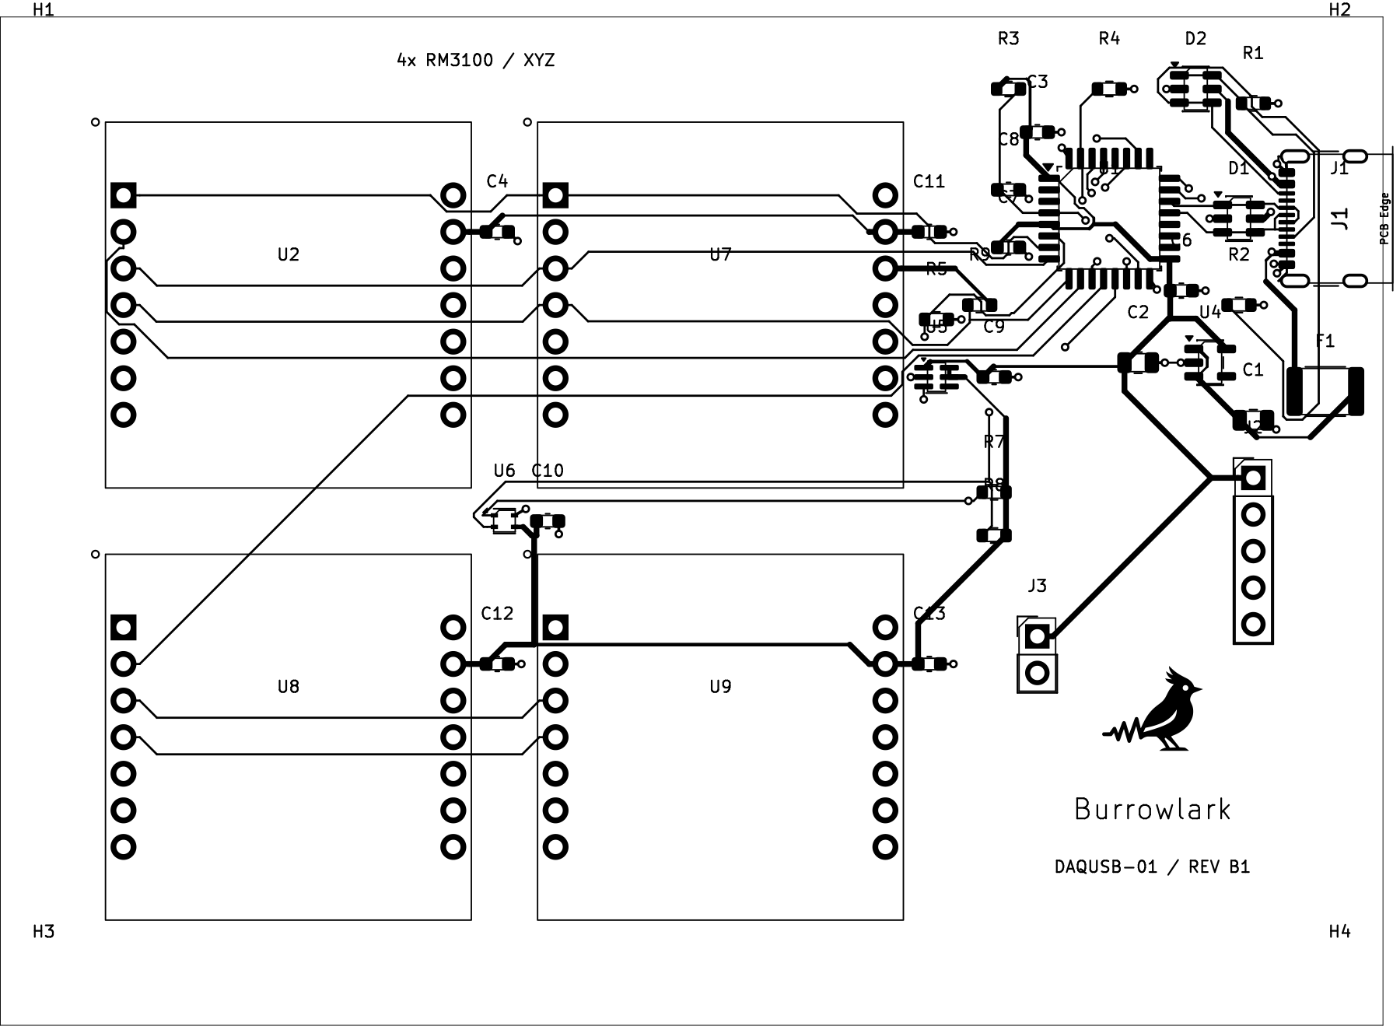
hw/burrowlark-usb/boards/groundlark-field-head/preview/assembly.png
