naturalhazardscience/groundlark/(list of files, drawings)

Other design files:
hw/burrowlark-usb/boards/groundlark-field-head/groundlark-field-head.dsn
