naturalhazardscience/groundlark/hw/groundlark-fpga-hat/boards/groundlark-daqhat-01/groundlark-daqhat-01.kicad_pcb

## KiCad design hw/groundlark-fpga-hat/boards/groundlark-daqhat-01/groundlark-daqhat-01.kicad_pcb (2026-10-20)

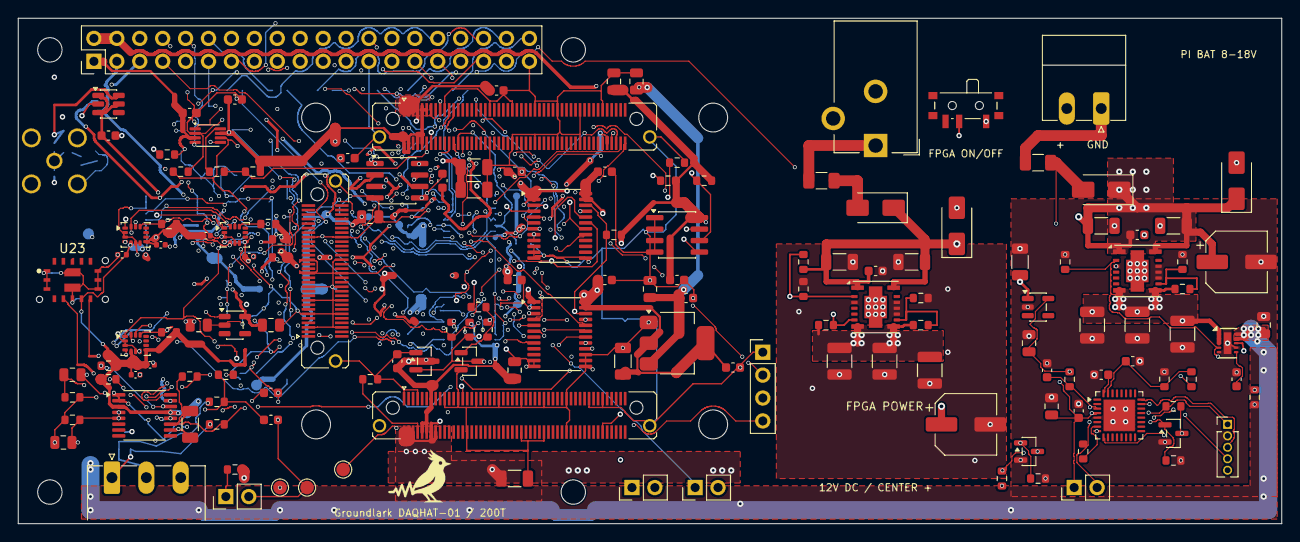
[picture p16: board groundlark-daqhat-01.kicad_pcb from above]

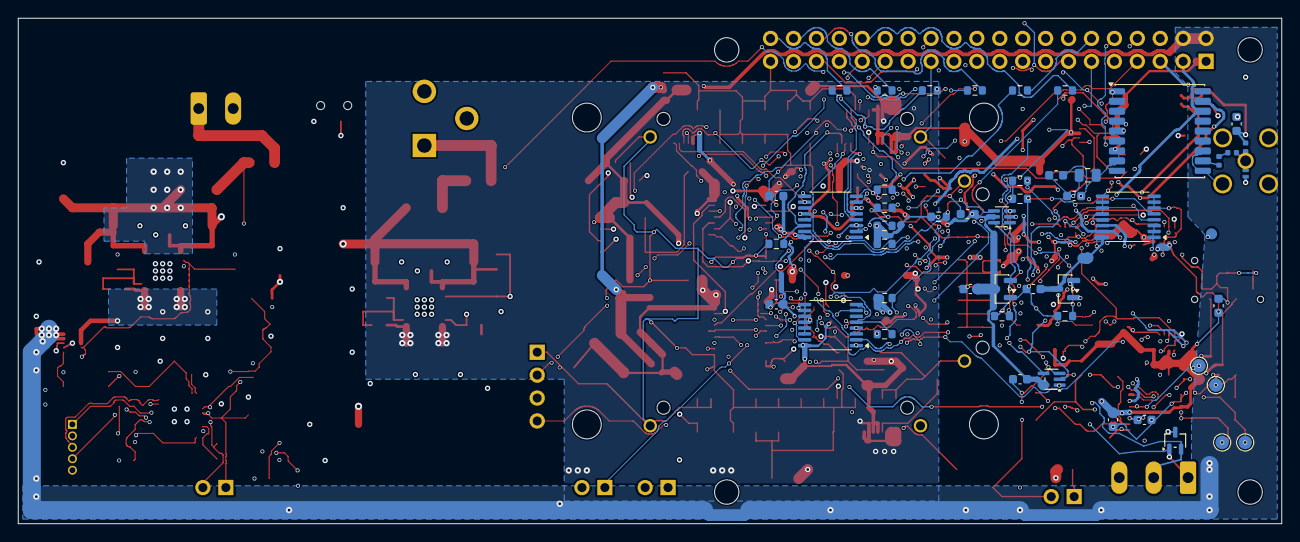
[picture p17: board groundlark-daqhat-01.kicad_pcb from below]

Board: 6 copper layers, 140.0 x 56.0 mm, 205 parts (48 on the bottom side), 110 nets.

Parts:
C1, C24, C41, C43, C44, C45, C46, C47, C48, C49, C75, C76, C77, C83, C95, C96, C100, C101, C102, C103, C104, C105, C106, C147, C152: 100n; Capacitor_SMD__C_0603_1608Metric
C2, C3, C40, C93, C94: 10u; Capacitor_SMD__C_0805_2012Metric
C12, C13, C14, C15, C16, C17: 100n; Capacitor_SMD__C_0402_1005Metric
C42, C80, C81, C82: 22u; Capacitor_SMD__C_1206_3216Metric
C84, C85, C146, C149, C150: 4.7u; Capacitor_SMD__C_0805_2012Metric
C86, C87, C131, C132, C133: 10u; PWR_C_1206_3216Metric
C88, C134, C141: 100n; PWR_C_0603_1608Metric
C89, C135: 47u; PWR_CP_Elec_6.3x7.7
C90: 100n C0G; Capacitor_SMD__C_1206_3216Metric
C91, C92: 1n C0G; Capacitor_SMD__C_0603_1608Metric
C110, C111, C112, C136, C137, C138: 22u; PWR_C_1210_3225Metric
C130: 4.7u; SUP_C_0805_2012Metric
C139, C144, C145, C151: 10n; SUP_C_0603_1608Metric
C140, C142: 10u; SUP_C_0805_2012Metric
C143: 470n; SUP_C_0603_1608Metric
C148: 47p C0G; GNSS_C0402
D80, D130: B340A; PWR_D_SMA
D81: SMAJ15A; PWR_D_SMA
D90: TPD2E2U06; Package_TO_SOT_SMD__SOT-323_SC-70
D131: SMAJ18A; SUP_D_SMA
D140: PESD5V0F1BL; GNSS_SOD882
F80: 0466002.NRHF; PWR_Fuse_1206_3216Metric
F130: 4A fuse; SUP_Fuse_1206_3216Metric
H1, H2, H3, H4: M2.5 NPTH; MountingHole__MountingHole_2.7mm_M2.5
H80, H81, H82, H83: M3 / 8 mm spacer; TZ_TZ_HOLE
J1: Raspberry Pi 40-pin; Connector_PinHeader_2.54mm__PinHeader_2x20_P2.54mm_Vertical
J4: FPGA test UART/reset; Connector_PinHeader_2.54mm__PinHeader_1x04_P2.54mm_Vertical
J80, J81: LSHM-150-04.0-L-DV-A-S-K-TR; TZ_TZ100
J82: LSHM-130-04.0-L-DV-A-S-K-TR; TZ_TZ60
J83: 12V DC / CENTER +; PWR_BarrelJack_CUI_PJ-102AH_Horizontal
J90: GEO + / - / SHIELD; Connector_Phoenix_MC__PhoenixContact_MC_1,5_3-G-3.81_1x03_P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
J130: PI BATTERY 8-18V; SUP_PhoenixContact_MC_1,5_2-G-3.81_1x02_P3.81mm_Horizontal
J131: SWD / 3V3 REF; SUP_PinHeader_1x05_P1.27mm_Vertical
J140: GNSS ANT / 3V3; GNSS_HL_SMA_KWE_02
JP1: EEPROM write enable; Connector_PinHeader_2.54mm__PinHeader_1x02_P2.54mm_Vertical
JP80, JP81: TSW-102-07-G-S; TZ_TZ_JP
JP130: BENCH RUN; SUP_PinHeader_1x02_P2.54mm_Vertical
L140: 56n; GNSS_HP0402
L141: 3.6n; GNSS_HP0402
Q1: 2N7002; Package_TO_SOT_SMD__SOT-23
Q130, Q131: 2N7002; SUP_SOT-23
R1, R2: 3.9k; Resistor_SMD__R_0603_1608Metric
R3, R65, R90, R91: 1k; Resistor_SMD__R_0603_1608Metric
R11, R12, R13, R50, R63, R64, R80, R81, R94, R95, R97, R106, R107, R108, R109, R110, R111, R113, R115, R118: 10k; Resistor_SMD__R_0603_1608Metric
R51, R62, R66, R112, R114, R116, R117: 100k; Resistor_SMD__R_0603_1608Metric
R52, R53: 4.7k; Resistor_SMD__R_0603_1608Metric
R61: 47; Resistor_SMD__R_0603_1608Metric
R92, R93: 1M; Resistor_SMD__R_0603_1608Metric
R96, R100, R101, R102, R103, R104, R105: 22; Resistor_SMD__R_0603_1608Metric
R120, R124, R130, R138, R141: 10k; PWR_R_0603_1608Metric
R121: 4.30k; PWR_R_0603_1608Metric
R122, R132, R137, R139, R140: 100k; PWR_R_0603_1608Metric
R123: 15k; PWR_R_0603_1608Metric
R131: 2.43k; SUP_R_0603_1608Metric
R133: 2k; SUP_R_0603_1608Metric
R134: 47k; SUP_R_0603_1608Metric
R135: 1M; SUP_R_0603_1608Metric
R136: 150k; SUP_R_0603_1608Metric
SW80: FPGA OFF / ON; PWR_SW_SPDT_PCM12
TP1: SENS_3V3; TestPoint__TestPoint_Pad_D1.5mm
TP2, TP90: GND; TestPoint__TestPoint_Pad_D1.5mm
TP4: SENSOR_OE_N; TestPoint__TestPoint_Pad_D1.5mm
TP91: GEO_VCM; TestPoint__TestPoint_Pad_D1.5mm
TP92: GEO_AVDD; TestPoint__TestPoint_Pad_D1.5mm
TP93: GEO_DRDY_N; TestPoint__TestPoint_Pad_D1.5mm
U1: 24LC32A; Package_SO__SOIC-8_3.9x4.9mm_P1.27mm
U11, U12, U13: LSM6DSOTR; Package_LGA__LGA-14_3x2.5mm_P0.5mm_LayoutBorder3x4y
U21: MAX-M10S-00B; RF_GPS__ublox_MAX
U22: ADS122C04; Package_SO__TSSOP-16_4.4x5mm_P0.65mm
U23: SDP32-125PA; Groundlark__SDP32
U40: TLV1117LV33DCYR; Package_TO_SOT_SMD__SOT-223-3_TabPin2
U41, U42: SN74LVC8T245PWR; Package_SO__TSSOP-24_4.4x7.8mm_P0.65mm
U43: ISO1640BDR; Package_SO__SOIC-8_3.9x4.9mm_P1.27mm
U51: TXU0202DCUR; Package_SO__VSSOP-8_2.3x2mm_P0.5mm
U52: TLV803EA30DBZR; Package_TO_SOT_SMD__SOT-23
U80, U132: TPSM53603; PWR_Texas_B3QFN-14-1EP_5x5.5mm_P0.65mm
U100, U101: TMUX1574PWR; Package_SO__TSSOP-16_4.4x5mm_P0.65mm
U102: TCA9534PWR; Package_SO__TSSOP-16_4.4x5mm_P0.65mm
U103: SN74LVC1G10DCKR; Package_TO_SOT_SMD__SOT-363_SC-70-6
U104, U105: TLV809EA30DBZR; Package_TO_SOT_SMD__SOT-23
U106: SN74LVC1G08DCKR; Package_TO_SOT_SMD__SOT-353_SC-70-5
U130: MSPM0L1106; SUP_QFN-32-1EP_5x5mm_P0.5mm_EP3.45x3.45mm
U131, U140: TPS70933; SUP_SOT-23-5
U133: TPS22953; SUP_Texas_WSON10_DQC0010A
U141: TPS2553; GNSS_SOT23_6

Connections:
BAT_FUSED: D130.2, F130.2, R135.1
BAT_INPUT: F130.1, J130.1
BAT_PROTECTED: C131.1, C132.1, C133.1, C134.1, C135.1, D130.1, D131.1, U131.1, U132.1, U132.14
BUCK_EN: R122.2, R123.1, SW80.2, U80.2
BUCK_FB: R120.2, R121.1, U80.9
EEP_WP: JP1.1, R3.1, U1.7
EXT_12V: F80.1, J83.1
FPGA_3V3: C76.1, C77.1, C84.1, C85.1, C100.1, C101.1, C103.1, C105.1, C106.1, J80.10, J80.12, J80.13, J81.2, J81.4, J81.8, J81.9, J81.10, J81.11, J81.92, R63.2, R64.2, R108.2, R111.2, R113.2, R115.2, U51.7, U52.3, U100.16, U101.16, U103.5, U105.3, U106.5
FPGA_CONFIG_RESET_N: J81.17, JP81.1
FPGA_EN1: J80.27, JP80.1, R124.2, U80.6
FPGA_IO_ENABLE: J1.22, R62.1, U51.6, U106.2
FPGA_JTAGEN: J80.90, R80.1
FPGA_LINK_CS_N: J81.23, R111.1, U101.2
FPGA_LINK_DQ0: J81.22, U100.5
FPGA_LINK_DQ1: J81.24, U100.11
FPGA_LINK_DQ2: J81.26, R116.1, U100.14
FPGA_LINK_DQ3: J81.28, R117.1, U101.5
FPGA_LINK_SCLK: J81.21, R112.1, U100.2
FPGA_NOSEQ: J80.8, R81.1
FPGA_RESET_GATE: Q1.1, R65.2, R66.1
FPGA_RESET_GPIO: J1.11, R65.1
FPGA_RESET_N: J4.4, J81.13, Q1.3, R64.1, U52.2
FPGA_UART_DRIVE: R61.1, U51.8
FPGA_UART_RX: J4.2, J81.12, R61.2, R63.1
FPGA_UART_TX: J4.3, J81.14, U51.1
FPGA_VIN: C80.1, C81.1, C82.1, C83.1, C110.1, C111.1, C112.1, J80.2, J80.4, J80.6, J80.14, J80.16, J81.1, J81.3, J81.5, J81.7, R120.1, R124.1, U80.7, U80.8
FUSED_12V: D80.2, F80.2
GEO_AIN_N: C90.2, C92.1, R91.2, R93.1, U22.10
GEO_AIN_P: C90.1, C91.1, R90.2, R92.1, U22.11
GEO_AVDD: C94.1, C95.1, R94.1, R96.2, TP92.1, U22.12
GEO_DRDY_N: R97.1, TP93.1, U22.14, U42.16
GEO_N: D90.2, J90.2, R91.1
GEO_P: D90.1, J90.1, R90.1
GEO_VCM: C93.1, R92.2, R93.2, R94.2, R95.1, TP91.1
GND: C1.2, C2.2, C3.2, C12.2, C13.2, C14.2, C15.2, C16.2, C17.2, C24.2, C40.2, C41.2, C42.2, C43.2, C44.2, C45.2, C46.2, C47.2, C48.2, C49.2, C75.2, C76.2, C77.2, C80.2, C81.2, C82.2, C83.2, C84.2, C85.2, C86.2, C87.2, C88.2, C89.2, C91.2, C92.2, C93.2, C94.2, C95.2, C96.2, C100.2, C101.2, C102.2, C103.2, C104.2, C105.2, C106.2, C110.2, C111.2, C112.2, C130.2, C131.2, C132.2, C133.2, C134.2, C135.2, C136.2, C137.2, C138.2, C139.2, C140.2, C141.2, C142.2, C143.2, C144.2, C145.2, C146.2, C147.2, C149.2, C150.2, C151.2, C152.2, D81.2, D90.3, D131.2, D140.2, J1.6, J1.9, J1.14, J1.20, J1.25, J1.30, J1.34, J1.39, J4.1, J80.1, J80.7, J80.19, J80.25, J80.30, J80.33, J80.43, J80.53, J80.54, J80.63, J80.64, J80.73, J80.74, J80.83, J80.89, J80.101, J81.19, J81.39, J81.40, J81.49, J81.50, J81.59, J81.60, J81.69, J81.70, J81.79, J81.80, J81.89, J81.101, J82.5, J82.6, J82.11, J82.12, J82.17, J82.18, J82.23, J82.24, J82.29, J82.30, J82.35, J82.36, J82.45, J82.46, J82.61, J83.2, J90.3, J130.2, J131.2, J140.2, JP1.2, JP80.2, JP81.2, Q1.2, Q130.2, Q131.2, R51.2, R62.2, R66.2, R80.2, R81.2, R95.2, R106.2, R107.2, R109.2, R110.2, R112.2, R114.2, R116.2, R117.2, R121.2, R123.2, R131.2, R132.2, R133.2, R136.2, R137.2, R139.2, SW80.1, TP2.1, TP90.1, U1.1, U1.2, U1.3, U1.4, U11.2, U11.3, U11.6, U11.7, U12.2, U12.3, U12.6, U12.7, U13.2, U13.3, U13.6, U13.7, U21.1, U21.5, U21.10, U21.12, U22.1, U22.2, U22.4, U22.5, U23.1, U23.2, U23.3, U23.6, U23.9, U23.10, U23.11, U23.17, U40.1, U41.8, U41.9, U41.10, U41.11, U41.12, U41.13, U42.2, U42.11, U42.12, U42.13, U42.14, U42.15, U42.17, U43.4, U43.5, U51.2, U52.1, U80.3, U80.10, U80.11, U80.12, U80.15, U100.8, U101.8, U101.9, U101.10, U101.11, U101.12, U101.13, U101.14, U102.1, U102.2, U102.3, U102.6, U102.7, U102.8, U102.9, U102.10, U102.11, U102.12, U103.2, U104.1, U105.1, U106.3, U130.5, U130.33, U131.2, U132.3, U132.10, U132.11, U132.12, U132.15, U133.5, U133.7, U133.11, U140.2, U141.2
GNSS_ANT: C148.1, D140.1, J140.1, L140.2
GNSS_BIAS: C151.1, L140.1, U141.6
GNSS_LDO: C150.1, C152.1, U140.5, U141.1, U141.3, U141.5
GNSS_MATCH: C148.2, L141.1
GNSS_PPS: J1.18, U21.4
GNSS_RF: L141.2, U21.11
I2C_SCL: R53.1, U22.16, U23.5, U43.3
I2C_SDA: R52.1, U22.15, U23.8, U43.2
ID_SCL: J1.28, R2.1, U1.6
ID_SDA: J1.27, R1.1, U1.5
IMU1_CS: R11.1, U11.12, U41.19
IMU1_INT: U11.4, U42.20
IMU2_CS: R12.1, U12.12, U41.18
IMU2_INT: U12.4, U42.19
IMU3_CS: R13.1, U13.12, U41.17
IMU3_INT: U13.4, U42.18
JTAG_TCK: J81.100, R114.1, U100.3
JTAG_TDI: J81.96, R115.1, U100.6
JTAG_TDO: J81.98, U100.10
JTAG_TMS: J81.94, R113.1, U100.13
LINK_ARMED_REQUEST: U103.1, U106.4
LINK_CS_N: R104.2, U101.4
LINK_DQ0: R101.2, U100.7
LINK_DQ1: R102.2, U100.9
LINK_DQ2: R103.2, U100.12
LINK_DQ3: R105.2, U101.7
LINK_FPGA_GOOD: R110.1, U103.6, U105.2
LINK_JTAG_SEL: R106.1, U100.1, U101.1, U102.4
LINK_OE_N: R108.1, U100.15, U101.15, U103.4
LINK_PI_GOOD: R109.1, U103.3, U104.2
LINK_REQUEST: R107.1, U102.5, U106.1
LINK_SCLK: R100.2, U100.4
PI_3V3: C1.1, C2.1, C44.1, C46.1, C49.1, C75.1, C102.1, C104.1, C146.1, C147.1, J1.1, J1.17, R1.2, R2.2, R3.2, R50.2, R118.2, R138.1, U1.8, U21.7, U21.8, U41.1, U41.2, U42.1, U43.8, U51.3, U102.16, U104.3
PI_5V: C3.1, C40.1, C41.1, C140.1, C149.1, J1.2, J1.4, R133.1, U40.3, U133.9, U133.10, U140.1
PI_BUCK_FB: R130.2, R131.1, U132.9
PI_GEO_DRDY_N: J1.7, U42.8
PI_HALTED: J1.33, Q131.1, R139.1
PI_I2C_SCL: J1.5, U21.17, U43.6, U102.14
PI_I2C_SDA: J1.3, U21.16, U43.7, U102.15
PI_IMU1_CS: J1.24, U41.5
PI_IMU1_INT: J1.13, U42.4
PI_IMU2_CS: J1.26, U41.6
PI_IMU2_INT: J1.15, U42.5
PI_IMU3_CS: J1.29, U41.7
PI_IMU3_INT: J1.16, U42.6
PI_LINK_CS_N: J1.12, R104.1
PI_LINK_DQ0: J1.38, R101.1
PI_LINK_DQ1: J1.35, R102.1
PI_LINK_DQ2: J1.36, R103.1
PI_LINK_DQ3: J1.32, R105.1
PI_LINK_SCLK: J1.40, R100.1
PI_RAW_5V: C136.1, C137.1, C138.1, R130.1, U132.7, U132.8, U133.1, U133.2, U133.3, U133.8
PI_SHUTDOWN_N: J1.31, Q130.3, R138.2
PI_SPI_MISO: J1.21, U42.3
PI_SPI_MOSI: J1.19, U41.3
PI_SPI_SCLK: J1.23, U41.4
PI_SWITCH_CT: C139.1, U133.6
PI_UART_RX: J1.10, R118.1, U51.4
PI_UART_TX: J1.8, U51.5
PROTECTED_12V: C86.1, C87.1, C88.1, C89.1, D80.1, D81.1, R122.1, U80.1, U80.14
SENSOR_OE_N: J1.37, R50.1, TP4.1, U41.22, U42.22
SENS_3V3: C12.1, C13.1, C14.1, C15.1, C16.1, C17.1, C24.1, C42.1, C43.1, C45.1, C47.1, C48.1, C96.1, R11.2, R12.2, R13.2, R52.2, R53.2, R96.1, R97.2, TP1.1, U11.5, U11.8, U12.5, U12.8, U13.5, U13.8, U22.3, U22.13, U23.7, U40.2, U41.23, U41.24, U42.23, U42.24, U43.1
SPI_MISO: R51.1, U11.1, U12.1, U13.1, U42.21
SPI_MOSI: U11.14, U12.14, U13.14, U41.21
SPI_SCLK: U11.13, U12.13, U13.13, U41.20
SUP_3V3: C130.1, C141.1, C142.1, J131.1, JP130.1, R134.2, R140.1, U130.4, U131.5
SUP_ACK_N: Q131.3, R140.2, U130.9
SUP_BAT_ADC: C145.1, R135.2, R136.1, U130.31
SUP_CORE: C143.1, U130.32
SUP_NRST: C144.1, J131.5, R134.1, U130.3
SUP_REQUEST: Q130.1, R137.1, U130.8
SUP_RUN: JP130.2, R132.1, R141.2, U132.2, U133.4
SUP_RUN_DRIVE: R141.1, U130.7
SUP_SWCLK: J131.3, U130.24
SUP_SWDIO: J131.4, U130.23
