naturalhazardscience/groundlark/hw/burrowlark-usb/boards/groundlark-field-head/groundlark-field-head.kicad_pcb

## KiCad design hw/burrowlark-usb/boards/groundlark-field-head/groundlark-field-head.kicad_pcb (2026-10-12)

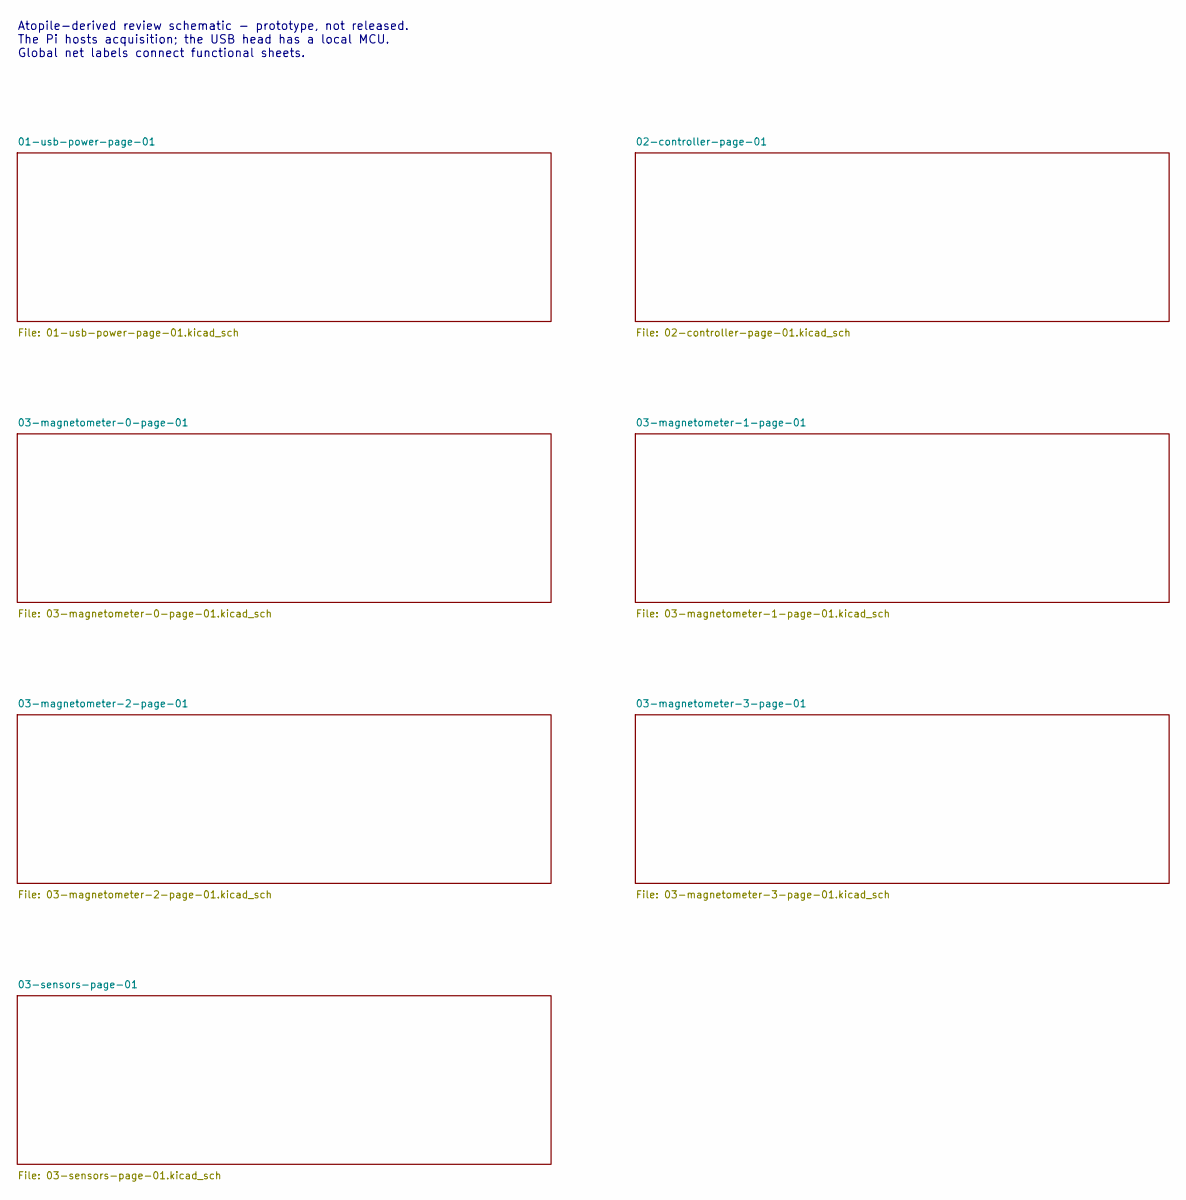
[picture p18: schematic groundlark-field-head.kicad_sch]

Notes on the sheet:
Atopile-derived review schematic - prototype, not released. The Pi hosts acquisition; the USB head has a local MCU. Global net labels connect functional sheets.

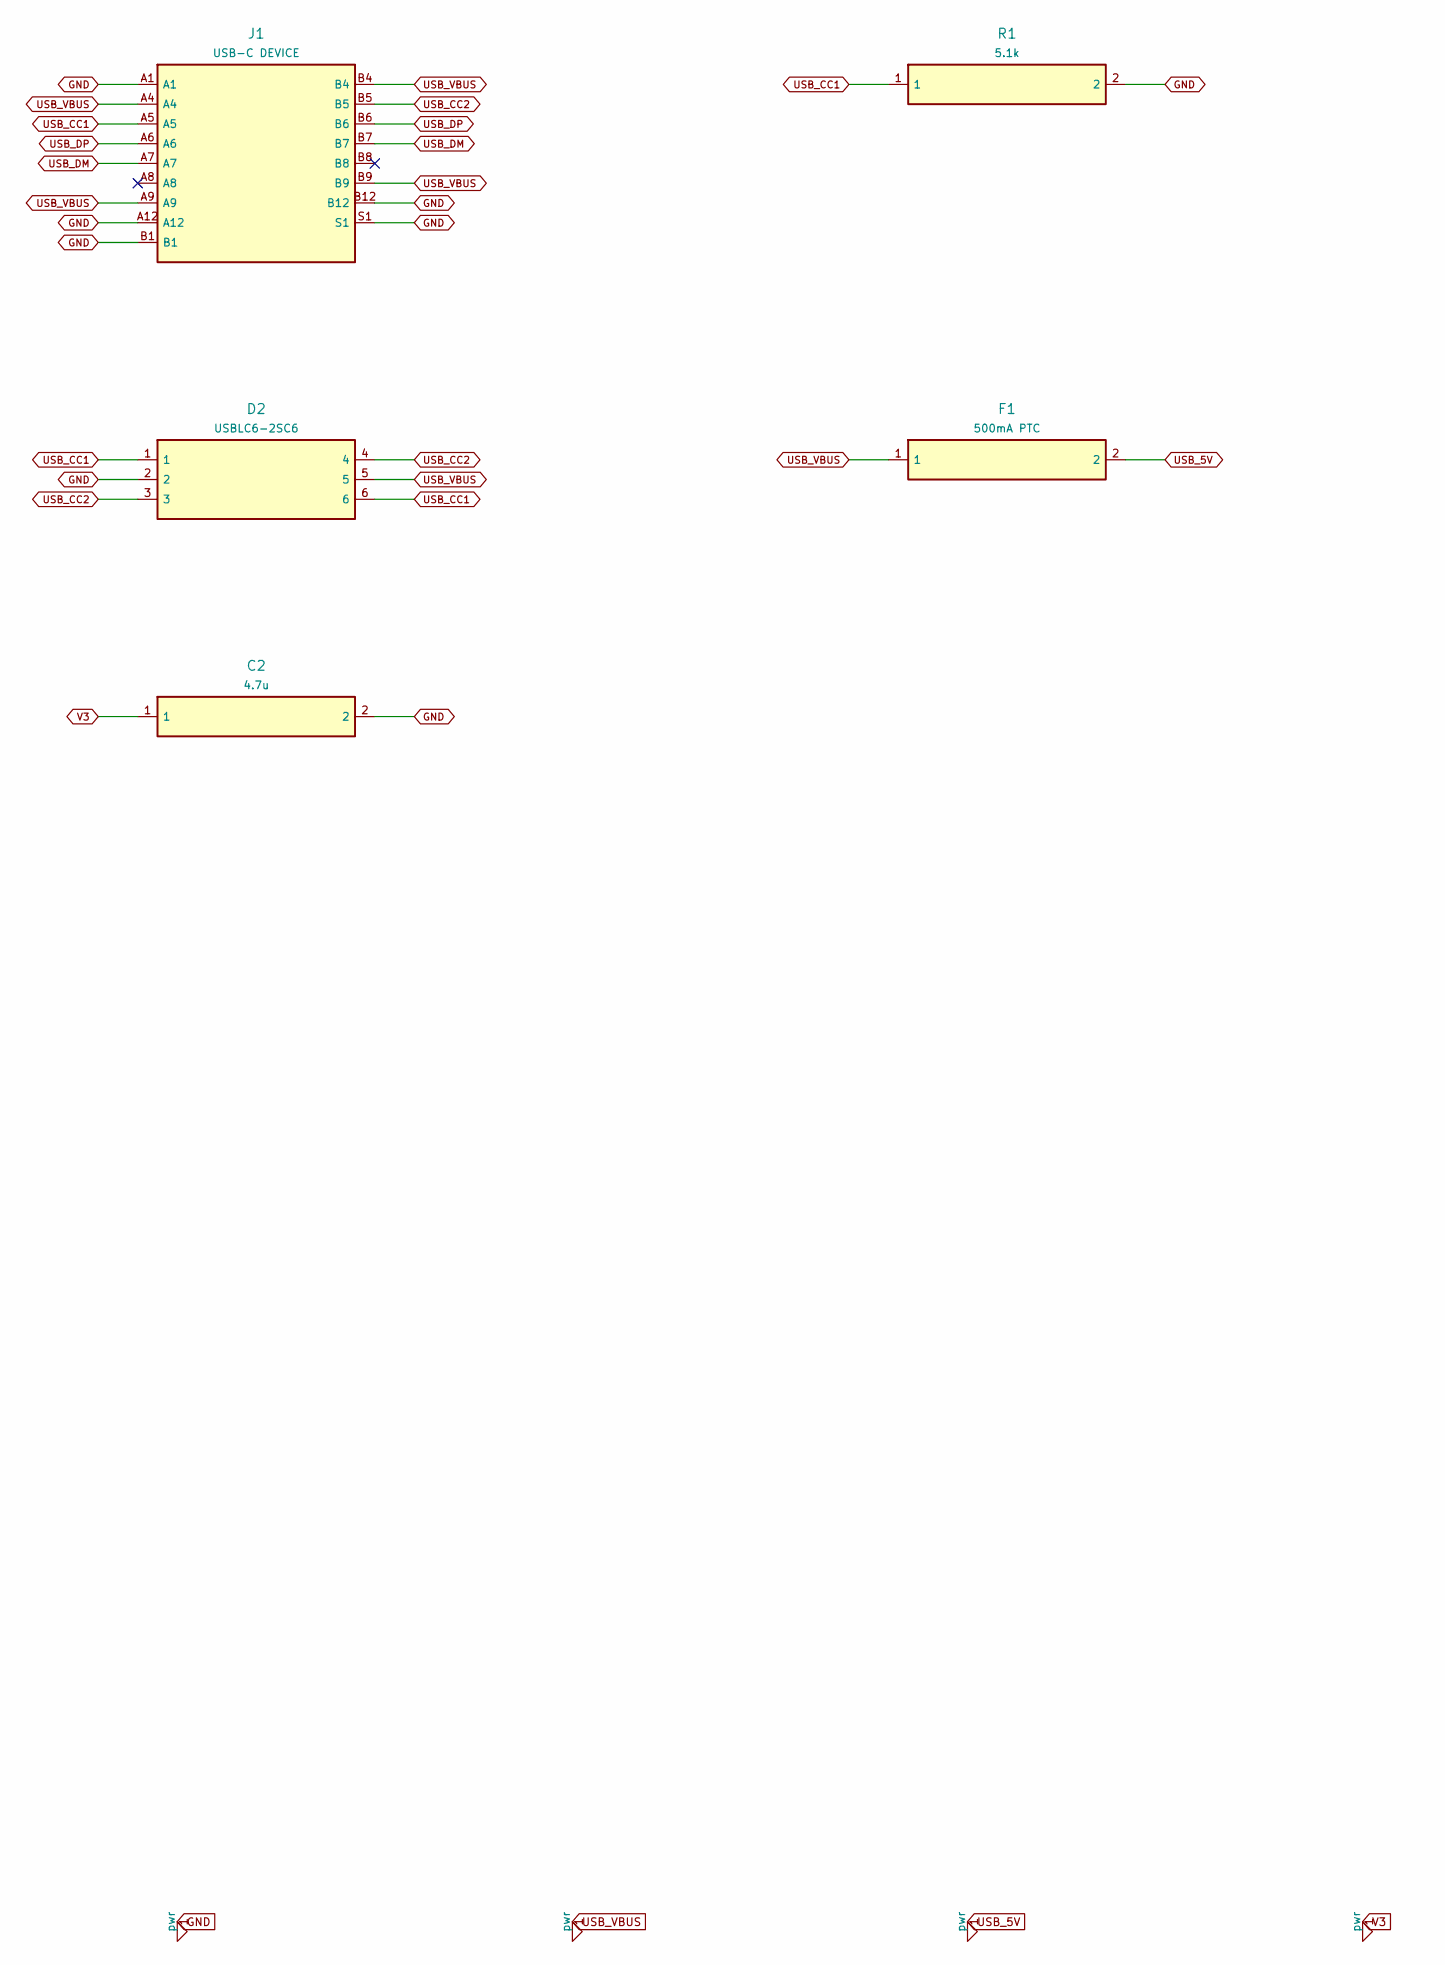
[picture p19: schematic 01-usb-power-page-01.kicad_sch, groundlark-field-head / 01-usb-power-page-01, part in row 1, column 1]

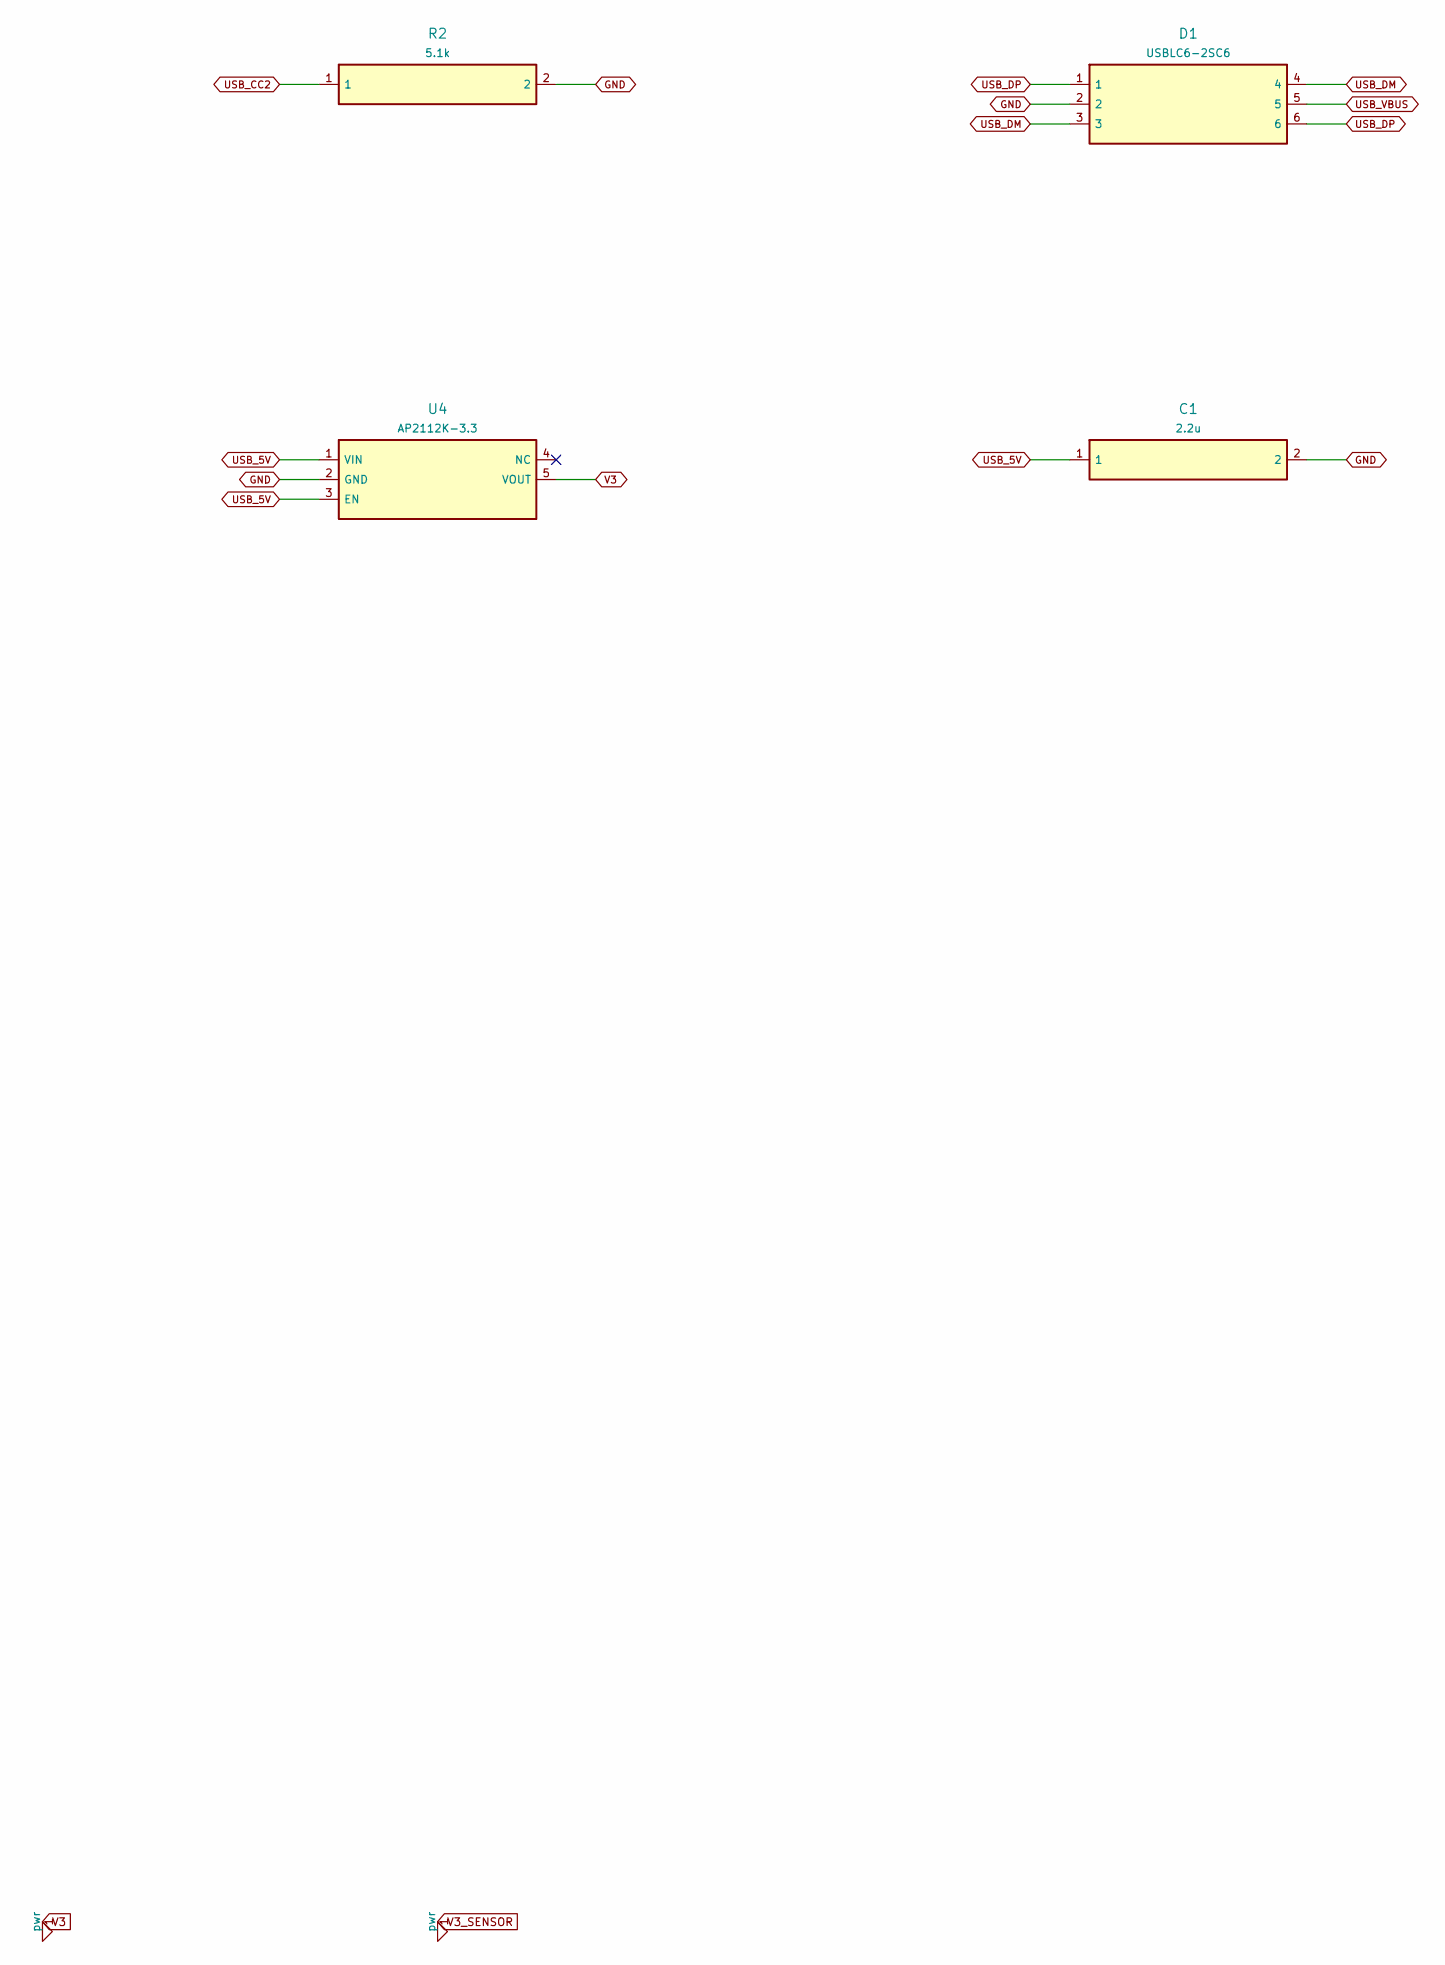
[picture p20: schematic 01-usb-power-page-01.kicad_sch, groundlark-field-head / 01-usb-power-page-01, part in row 1, column 2]

Parts:
C1: 2.2u; Capacitor_SMD__C_0805_2012Metric; MPN GRM21BR71E225KA73L
C2: 4.7u; Capacitor_SMD__C_0805_2012Metric; MPN GRM21BR71A475KA73L
D1, D2: USBLC6-2SC6; Package_TO_SOT_SMD__SOT-23-6; MPN USBLC6-2SC6
F1: 500mA PTC; Fuse__Fuse_1812_4532Metric; MPN MF-MSMF050-2
J1: USB-C DEVICE; Connector_USB__USB_C_Receptacle_GCT_USB4105-xx-A_16P_TopMnt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; MPN USB4105-GF-A
R1, R2: 5.1k; Resistor_SMD__R_0603_1608Metric; MPN RC0603FR-075K1L
U4: AP2112K-3.3; Package_TO_SOT_SMD__SOT-23-5; MPN AP2112K-3.3TRG1

Connections:
4: U4.4 (NC)
A8: J1.A8
B8: J1.B8
GND: C1.2, C2.2, D1.2, D2.2, J1.A1, J1.A12, J1.B1, J1.B12, J1.S1, R1.2, R2.2, U4.2 (GND); also elsewhere on the board
USB_5V: C1.1, F1.2, U4.1 (VIN), U4.3 (EN)
USB_CC1: D2.1, D2.6, J1.A5, R1.1
USB_CC2: D2.3, D2.4, J1.B5, R2.1
USB_DM: D1.3, D1.4, J1.A7, J1.B7; also elsewhere on the board
USB_DP: D1.1, D1.6, J1.A6, J1.B6; also elsewhere on the board
USB_VBUS: D1.5, D2.5, F1.1, J1.A4, J1.A9, J1.B4, J1.B9
V3: C2.1, U4.5 (VOUT); also elsewhere on the board

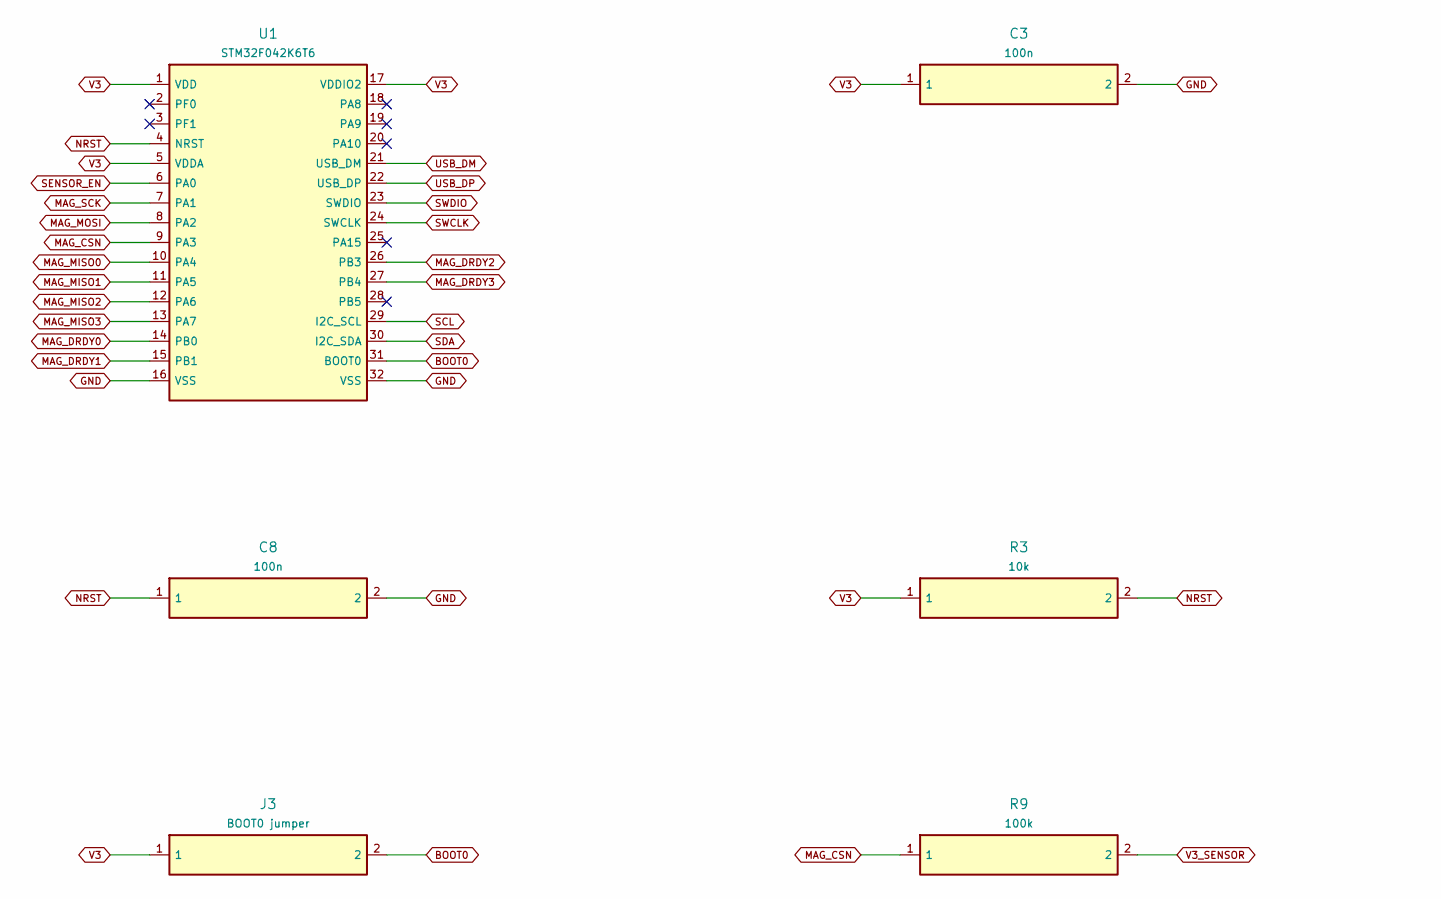
[picture p21: schematic 02-controller-page-01.kicad_sch, groundlark-field-head / 02-controller-page-01, part in row 1, column 1]

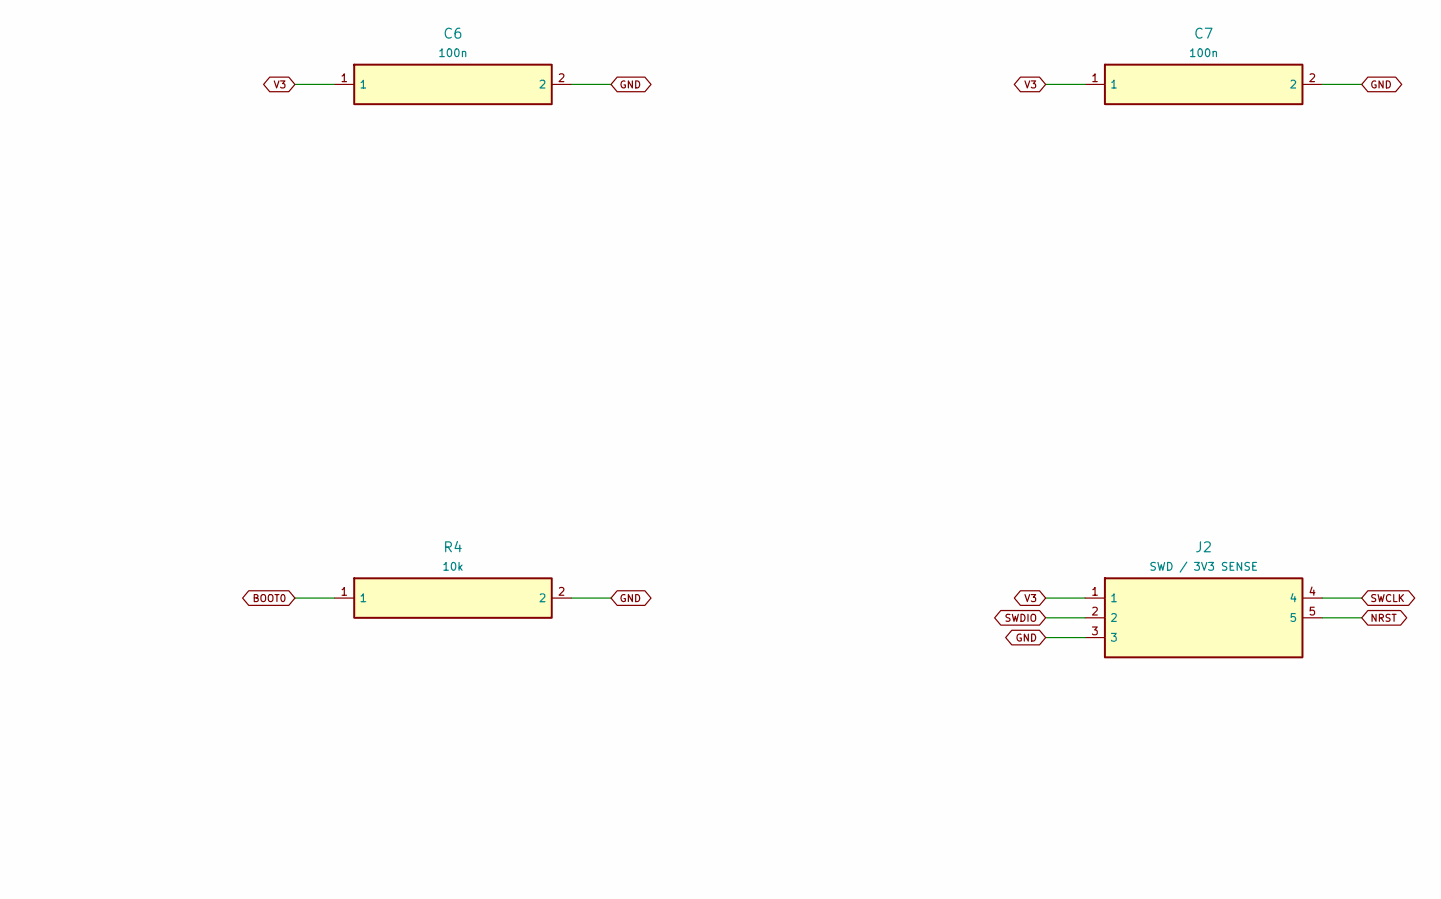
[picture p22: schematic 02-controller-page-01.kicad_sch, groundlark-field-head / 02-controller-page-01, part in row 1, column 2]

Parts:
C3, C6, C7, C8: 100n; Capacitor_SMD__C_0603_1608Metric; MPN GRM188R71H104KA93D
J2: SWD / 3V3 SENSE; Connector_PinHeader_2.54mm__PinHeader_1x05_P2.54mm_Vertical; MPN M20-9990545
J3: BOOT0 jumper; Connector_PinHeader_2.54mm__PinHeader_1x02_P2.54mm_Vertical; MPN EEPROM write enable
R3, R4: 10k; Resistor_SMD__R_0603_1608Metric; MPN RC0603FR-0710KL
R9: 100k; Resistor_SMD__R_0603_1608Metric; MPN RC0603FR-07100KL
U1: STM32F042K6T6; Package_QFP__LQFP-32_7x7mm_P0.8mm; MPN STM32F042K6T6

Connections:
2: U1.2 (PF0)
3: U1.3 (PF1)
18: U1.18 (PA8)
19: U1.19 (PA9)
20: U1.20 (PA10)
25: U1.25 (PA15)
28: U1.28 (PB5)
BOOT0: J3.2, R4.1, U1.31 (BOOT0)
GND: C3.2, C6.2, C7.2, C8.2, J2.3, R4.2, U1.16 (VSS), U1.32 (VSS); also elsewhere on the board
MAG_CSN: R9.1, U1.9 (PA3); also elsewhere on the board
MAG_DRDY0: U1.14 (PB0); also elsewhere on the board
MAG_DRDY1: U1.15 (PB1); also elsewhere on the board
MAG_DRDY2: U1.26 (PB3); also elsewhere on the board
MAG_DRDY3: U1.27 (PB4); also elsewhere on the board
MAG_MISO0: U1.10 (PA4); also elsewhere on the board
MAG_MISO1: U1.11 (PA5); also elsewhere on the board
MAG_MISO2: U1.12 (PA6); also elsewhere on the board
MAG_MISO3: U1.13 (PA7); also elsewhere on the board
MAG_MOSI: U1.8 (PA2); also elsewhere on the board
MAG_SCK: U1.7 (PA1); also elsewhere on the board
NRST: C8.1, J2.5, R3.2, U1.4 (NRST)
SCL: U1.29 (I2C_SCL); also elsewhere on the board
SDA: U1.30 (I2C_SDA); also elsewhere on the board
SENSOR_EN: U1.6 (PA0); also elsewhere on the board
SWCLK: J2.4, U1.24 (SWCLK)
SWDIO: J2.2, U1.23 (SWDIO)
USB_DM: U1.21 (USB_DM); also elsewhere on the board
USB_DP: U1.22 (USB_DP); also elsewhere on the board
V3: C3.1, C6.1, C7.1, J2.1, J3.1, R3.1, U1.1 (VDD), U1.5 (VDDA), U1.17 (VDDIO2); also elsewhere on the board
V3_SENSOR: R9.2; also elsewhere on the board

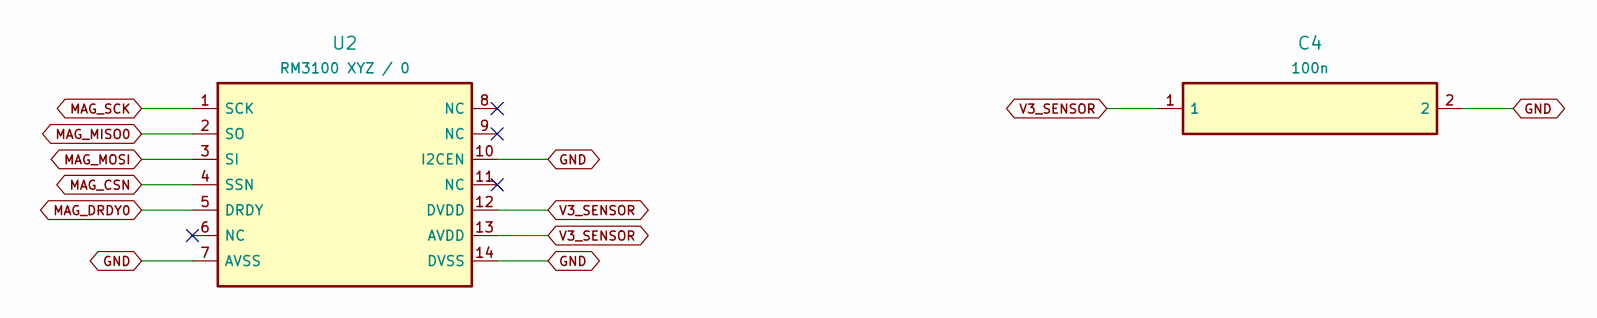
[picture p23: schematic 03-magnetometer-0-page-01.kicad_sch, groundlark-field-head / 03-magnetometer-0-page-01]

Parts:
C4: 100n; Capacitor_SMD__C_0603_1608Metric; MPN GRM188R71H104KA93D
U2: RM3100 XYZ / 0; Groundlark__PNI_14190_Module; MPN PNI 14190

Connections:
6: U2.6 (NC)
8: U2.8 (NC)
9: U2.9 (NC)
11: U2.11 (NC)
GND: C4.2, U2.7 (AVSS), U2.10 (I2CEN), U2.14 (DVSS); also elsewhere on the board
MAG_CSN: U2.4 (SSN); also elsewhere on the board
MAG_DRDY0: U2.5 (DRDY); also elsewhere on the board
MAG_MISO0: U2.2 (SO); also elsewhere on the board
MAG_MOSI: U2.3 (SI); also elsewhere on the board
MAG_SCK: U2.1 (SCK); also elsewhere on the board
V3_SENSOR: C4.1, U2.12 (DVDD), U2.13 (AVDD); also elsewhere on the board

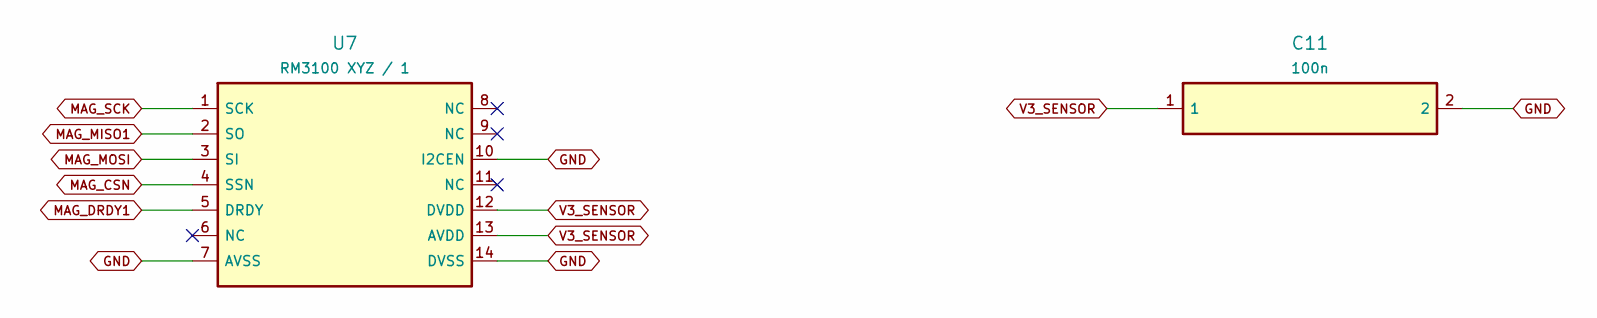
[picture p24: schematic 03-magnetometer-1-page-01.kicad_sch, groundlark-field-head / 03-magnetometer-1-page-01]

Parts:
C11: 100n; Capacitor_SMD__C_0603_1608Metric; MPN GRM188R71H104KA93D
U7: RM3100 XYZ / 1; Groundlark__PNI_14190_Module; MPN PNI 14190

Connections:
GND: C11.2, U7.7 (AVSS), U7.10 (I2CEN), U7.14 (DVSS); also elsewhere on the board
MAG_CSN: U7.4 (SSN); also elsewhere on the board
MAG_DRDY1: U7.5 (DRDY); also elsewhere on the board
MAG_MISO1: U7.2 (SO); also elsewhere on the board
MAG_MOSI: U7.3 (SI); also elsewhere on the board
MAG_SCK: U7.1 (SCK); also elsewhere on the board
V3_SENSOR: C11.1, U7.12 (DVDD), U7.13 (AVDD); also elsewhere on the board
u7-6: U7.6 (NC)
u7-8: U7.8 (NC)
u7-9: U7.9 (NC)
u7-11: U7.11 (NC)

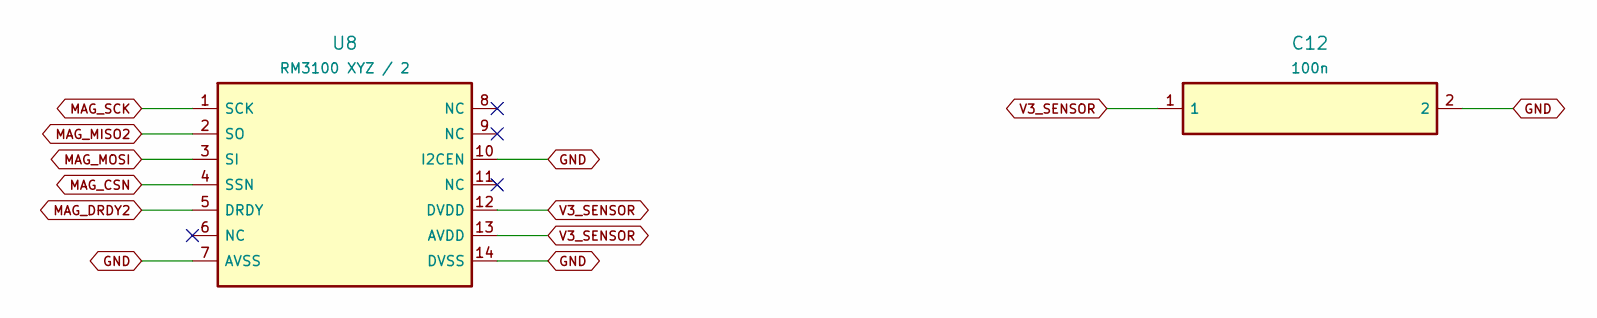
[picture p25: schematic 03-magnetometer-2-page-01.kicad_sch, groundlark-field-head / 03-magnetometer-2-page-01]

Parts:
C12: 100n; Capacitor_SMD__C_0603_1608Metric; MPN GRM188R71H104KA93D
U8: RM3100 XYZ / 2; Groundlark__PNI_14190_Module; MPN PNI 14190

Connections:
GND: C12.2, U8.7 (AVSS), U8.10 (I2CEN), U8.14 (DVSS); also elsewhere on the board
MAG_CSN: U8.4 (SSN); also elsewhere on the board
MAG_DRDY2: U8.5 (DRDY); also elsewhere on the board
MAG_MISO2: U8.2 (SO); also elsewhere on the board
MAG_MOSI: U8.3 (SI); also elsewhere on the board
MAG_SCK: U8.1 (SCK); also elsewhere on the board
V3_SENSOR: C12.1, U8.12 (DVDD), U8.13 (AVDD); also elsewhere on the board
u8-6: U8.6 (NC)
u8-8: U8.8 (NC)
u8-9: U8.9 (NC)
u8-11: U8.11 (NC)

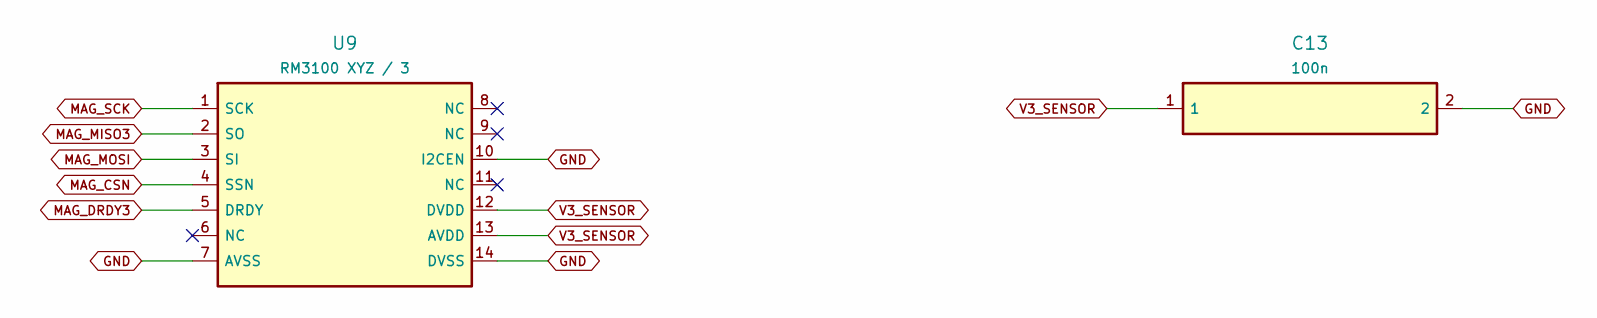
[picture p26: schematic 03-magnetometer-3-page-01.kicad_sch, groundlark-field-head / 03-magnetometer-3-page-01]

Parts:
C13: 100n; Capacitor_SMD__C_0603_1608Metric; MPN GRM188R71H104KA93D
U9: RM3100 XYZ / 3; Groundlark__PNI_14190_Module; MPN PNI 14190

Connections:
GND: C13.2, U9.7 (AVSS), U9.10 (I2CEN), U9.14 (DVSS); also elsewhere on the board
MAG_CSN: U9.4 (SSN); also elsewhere on the board
MAG_DRDY3: U9.5 (DRDY); also elsewhere on the board
MAG_MISO3: U9.2 (SO); also elsewhere on the board
MAG_MOSI: U9.3 (SI); also elsewhere on the board
MAG_SCK: U9.1 (SCK); also elsewhere on the board
V3_SENSOR: C13.1, U9.12 (DVDD), U9.13 (AVDD); also elsewhere on the board
u9-6: U9.6 (NC)
u9-8: U9.8 (NC)
u9-9: U9.9 (NC)
u9-11: U9.11 (NC)
