naturalhazardscience/groundlark/hw/burrowlark-usb/boards/groundlark-field-head/groundlark-field-head.kicad_pcb

## KiCad design hw/burrowlark-usb/boards/groundlark-field-head/groundlark-field-head.kicad_pcb (continued)

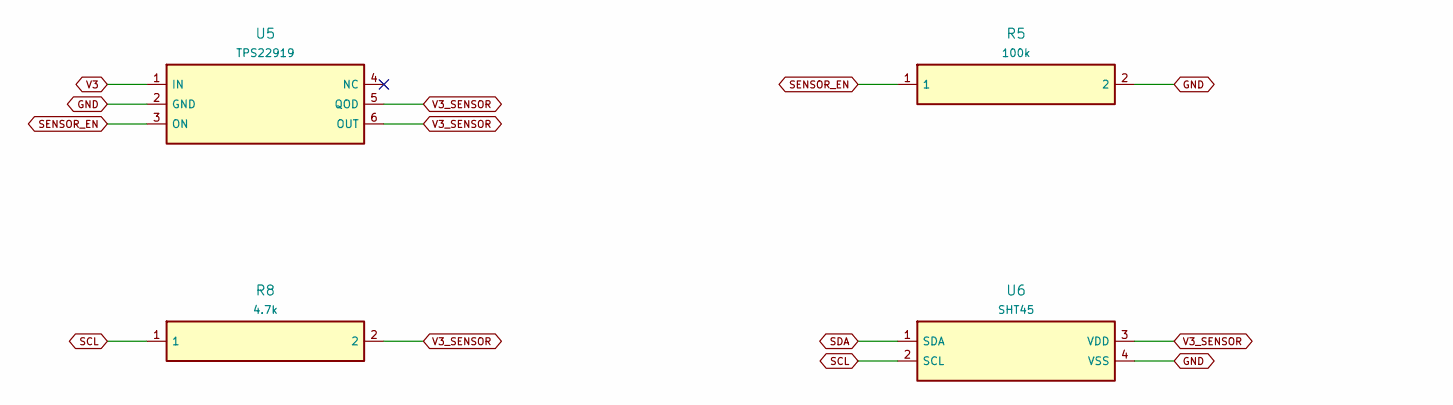
[picture p27: schematic 03-sensors-page-01.kicad_sch, groundlark-field-head / 03-sensors-page-01, part in row 1, column 1]

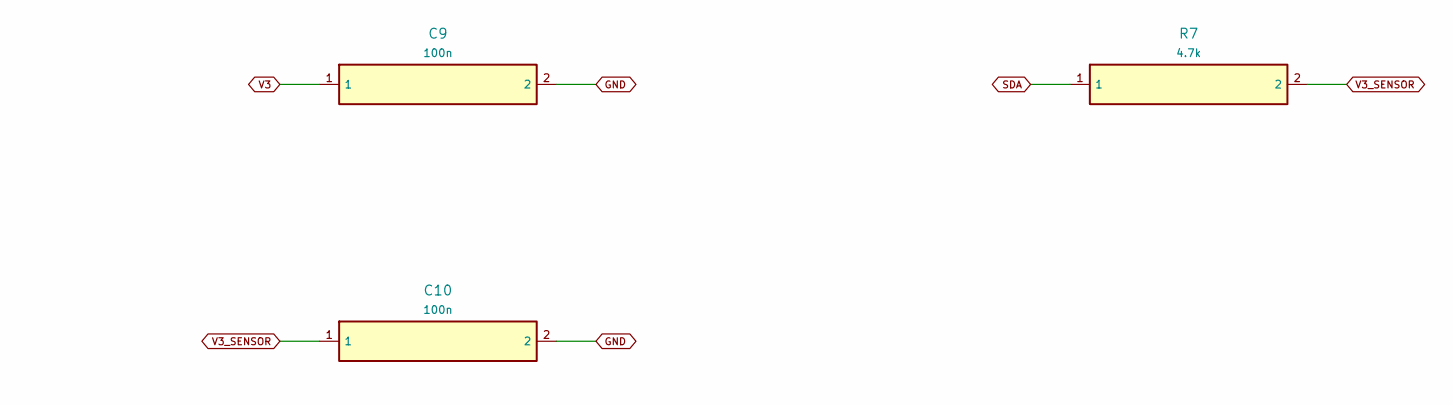
[picture p28: schematic 03-sensors-page-01.kicad_sch, groundlark-field-head / 03-sensors-page-01, part in row 1, column 2]

Parts:
C9, C10: 100n; Capacitor_SMD__C_0603_1608Metric; MPN GRM188R71H104KA93D
R5: 100k; Resistor_SMD__R_0603_1608Metric; MPN RC0603FR-07100KL
R7, R8: 4.7k; Resistor_SMD__R_0603_1608Metric; MPN RC0603FR-074K7L
U5: TPS22919; Package_TO_SOT_SMD__SOT-363_SC-70-6; MPN TPS22919DCKR
U6: SHT45; MPN SHT45-AD1B-R2

Connections:
GND: C9.2, C10.2, R5.2, U5.2 (GND), U6.4 (VSS); also elsewhere on the board
SCL: R8.1, U6.2 (SCL); also elsewhere on the board
SDA: R7.1, U6.1 (SDA); also elsewhere on the board
SENSOR_EN: R5.1, U5.3 (ON); also elsewhere on the board
V3: C9.1, U5.1 (IN); also elsewhere on the board
V3_SENSOR: C10.1, R7.2, R8.2, U5.5 (QOD), U5.6 (OUT), U6.3 (VDD); also elsewhere on the board
u5-4: U5.4 (NC)

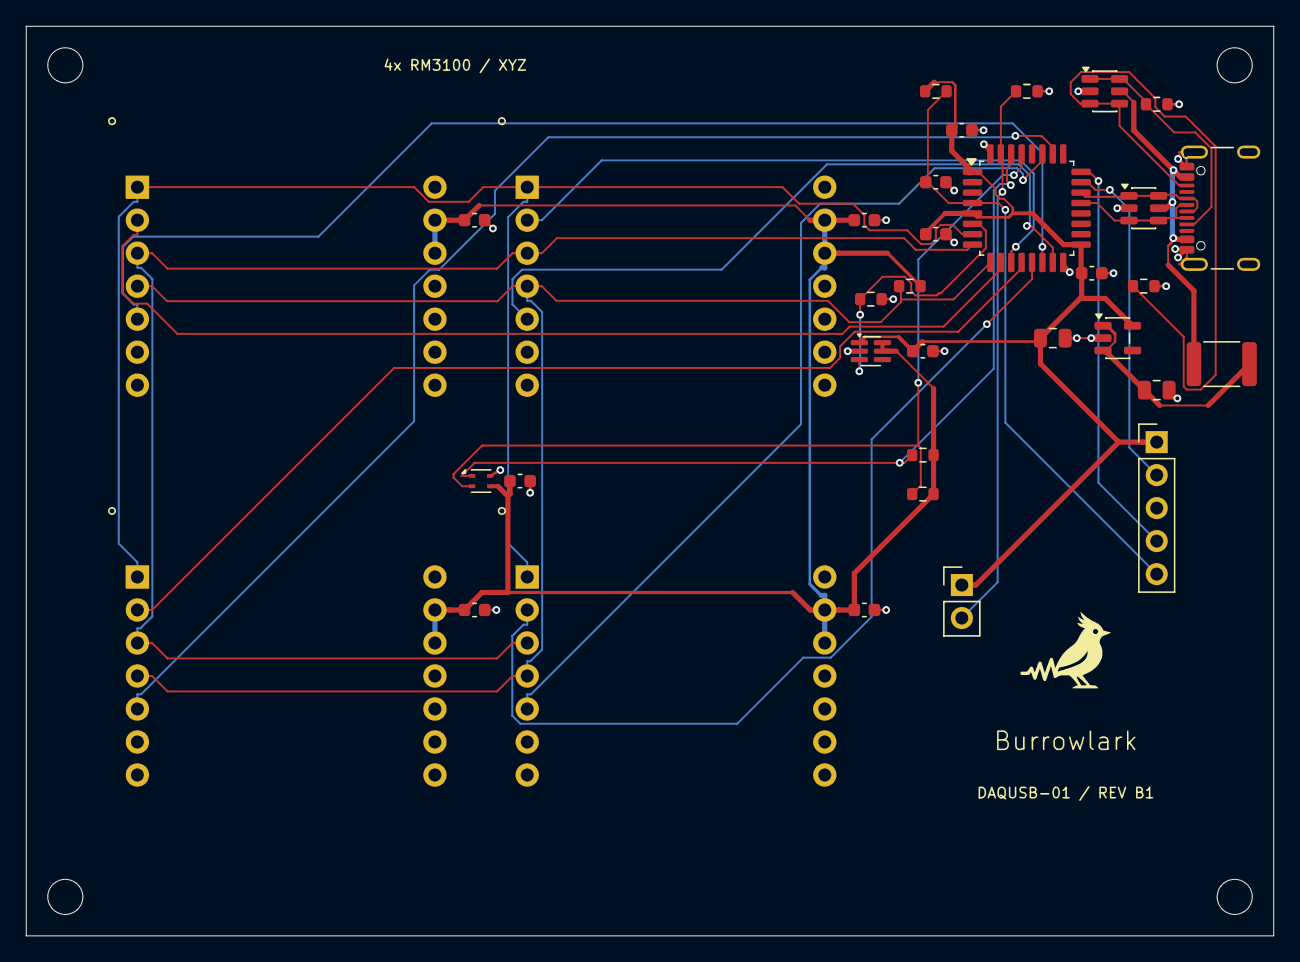
[picture p29: board groundlark-field-head.kicad_pcb from above]

Board: 4 copper layers, 96.0 x 70.0 mm, 38 parts (0 on the bottom side), 27 nets.

Other parts of the board:
H1, H2, H3, H4: M2.5 NPTH; MountingHole__MountingHole_2.7mm_M2.5
