naturalhazardscience/groundlark/hw/tools/pi_power_checks.py

"""Independent supply/control pin fixture from TI MSPM0L110x, TPS709,
TPSM53603 and TPS22953 data sheets; Nexperia 2N7002 SOT23 pin table.

These checks do not qualify battery thresholds, startup, thermals or noise.
"""
from hardware_require import require as _require_hardware
from collections import Counter
import math

PINS = {
 ('U130','3'):'SUP_NRST', ('U130','4'):'SUP_3V3', ('U130','5'):'GND',
 ('U130','7'):'SUP_RUN_DRIVE', ('U130','8'):'SUP_REQUEST', ('U130','9'):'SUP_ACK_N',
 ('U130','23'):'SUP_SWDIO', ('U130','24'):'SUP_SWCLK', ('U130','31'):'SUP_BAT_ADC',
 ('U130','32'):'SUP_CORE', ('U130','33'):'GND',
 ('U131','1'):'BAT_PROTECTED', ('U131','2'):'GND', ('U131','5'):'SUP_3V3',
 ('U132','1'):'BAT_PROTECTED', ('U132','14'):'BAT_PROTECTED', ('U132','2'):'SUP_RUN',
 ('U132','7'):'PI_RAW_5V', ('U132','8'):'PI_RAW_5V', ('U132','9'):'PI_BUCK_FB',
 ('U133','1'):'PI_RAW_5V', ('U133','2'):'PI_RAW_5V', ('U133','3'):'PI_RAW_5V',
 ('U133','4'):'SUP_RUN', ('U133','5'):'GND', ('U133','6'):'PI_SWITCH_CT', ('U133','7'):'GND',
 ('U133','8'):'PI_RAW_5V', ('U133','9'):'PI_5V', ('U133','10'):'PI_5V', ('U133','11'):'GND',
 ('J130','1'):'BAT_INPUT', ('J130','2'):'GND',
 ('F130','1'):'BAT_INPUT', ('F130','2'):'BAT_FUSED',
 ('D130','1'):'BAT_PROTECTED', ('D130','2'):'BAT_FUSED',
 ('D131','1'):'BAT_PROTECTED', ('D131','2'):'GND',
 ('Q130','1'):'SUP_REQUEST', ('Q130','2'):'GND', ('Q130','3'):'PI_SHUTDOWN_N',
 ('Q131','1'):'PI_HALTED', ('Q131','2'):'GND', ('Q131','3'):'SUP_ACK_N',
 ('J1','31'):'PI_SHUTDOWN_N', ('J1','33'):'PI_HALTED', ('J1','2'):'PI_5V', ('J1','4'):'PI_5V',
 ('R138','1'):'PI_3V3', ('R138','2'):'PI_SHUTDOWN_N',
 ('R140','1'):'SUP_3V3', ('R140','2'):'SUP_ACK_N',
 ('R132','1'):'SUP_RUN', ('R132','2'):'GND',
 ('R141','1'):'SUP_RUN_DRIVE', ('R141','2'):'SUP_RUN',
 ('R130','1'):'PI_RAW_5V', ('R130','2'):'PI_BUCK_FB',
 ('R131','1'):'PI_BUCK_FB', ('R131','2'):'GND',
 ('R135','1'):'BAT_FUSED', ('R135','2'):'SUP_BAT_ADC',
 ('R136','1'):'SUP_BAT_ADC', ('R136','2'):'GND',
 ('C143','1'):'SUP_CORE', ('C143','2'):'GND',
 ('J131','1'):'SUP_3V3', ('J131','2'):'GND', ('J131','3'):'SUP_SWCLK',
 ('J131','4'):'SUP_SWDIO', ('J131','5'):'SUP_NRST',
}
for pin in ('3','10','11','12','15'):PINS['U132',pin]='GND'
NC = [('U131','3'),('U131','4'),('U132','4'),('U132','5'),('U132','6'),('U132','13')]
NC += [('U130',str(n)) for n in range(1,34) if ('U130',str(n)) not in PINS]


def verify(pins):
    for key, net in PINS.items():
        if pins.get(key) != net:raise ValueError(f'Pi power/control pin mismatch: {key}')
    degree = Counter(pins.values())
    for key in NC:
        if not pins.get(key) or degree[pins[key]] != 1:
            raise ValueError(f'Required no-connect changed: {key}')
    if degree['SUP_CORE'] != 2:raise ValueError('VCORE must drive only its tank capacitor')
    return len(PINS)


def budget(current_a=3, switch_ohm=.025, copper_ohm=.05):
    if any(type(v) not in (int,float) or not math.isfinite(v) or v<0
           for v in (current_a,switch_ohm,copper_ohm)):
        raise ValueError('Supply envelope requires finite nonnegative numbers')
    if not 0 <= current_a <= 3:raise ValueError('Pi and HAT combined allocation is 3 A')
    # TI full-temperature reference +/-1.5%; independent 0.1%, 25 ppm/K
    # resistors over -40..85 C (65 K from 25 C), 50 nA FB bias.
    tolerance=.001+25e-6*65
    low=.985*(1+10000*(1-tolerance)/(2430*(1+tolerance)))-50e-9*10000*(1+tolerance)-.02
    high=1.015*(1+10000*(1+tolerance)/(2430*(1-tolerance)))+50e-9*10000*(1+tolerance)+.02
    return dict(nominal_V=1+10000/2430, minimum_V=low-current_a*(switch_ohm+copper_ohm),
                maximum_V=high, total_A=current_a, input_range_V=[8,18],
                input_scenario_A=(1+10000/2430)*current_a/(7.5*.85),
                resistor_temperature_range_C=[-40,85], ripple_transient_allowance_V=.02,
                adc_at_18V=18*150000*1.001/(1000000*.999+150000*1.001),
                copper_budget_ohm=copper_ohm, switch_budget_ohm=switch_ohm,
                measured=False)


def diode_spreader(board):
    import pcbnew as p
    diode=next(f for f in board.GetFootprints() if f.GetReference()=='D130')
    cathode=next(q for q in diode.Pads() if q.GetNumber()=='1')
    areas={}
    for layer in (p.F_Cu,p.B_Cu):
        polygons=[z.GetFilledPolysList(layer) for z in board.Zones()
                  if z.GetNetname()=='BAT_PROTECTED' and z.IsOnLayer(layer) and not z.GetIsRuleArea()]
        connected=[poly for poly in polygons if poly.Contains(cathode.GetPosition())]
        areas[board.GetLayerName(layer)]=sum(poly.Area()/1e12 for poly in connected)
        if areas[board.GetLayerName(layer)]<40:raise ValueError('D130 cathode heat-spreading copper missing')
    vias=[t for t in board.GetTracks() if isinstance(t,p.PCB_VIA) and t.GetNetname()=='BAT_PROTECTED'
          and 171<=p.ToMM(t.GetPosition().x)<=176 and 66<=p.ToMM(t.GetPosition().y)<=72]
    if len(vias)<6:raise ValueError('D130 heat-spreading through-vias missing')
    # This loss is an input-sizing scenario, not a thermal simulation.
    current=budget()['input_scenario_A']
    return dict(cathode_copper_area_mm2=areas,through_vias=len(vias),input_scenario_A=current,
                diode_forward_drop_assumed_V=.5,loss_scenario_W=current*.5,
                thermal_resistance_measured=False,junction_temperature_C=None,qualified=False,
                bench_status='open',bench_requirement='D130 junction-temperature qualification at 8 V input / 3 A combined load in the closed enclosure; copper/via counts do not close this item')


def verify_board(board, spec):
    import pcbnew as p
    pins={(f.GetReference(),q.GetNumber()):q.GetNetname() for f in board.GetFootprints() for q in f.Pads() if q.GetNumber()}
    checks=verify(pins); fps={f.GetReference():f for f in board.GetFootprints()};meta={x['ref']:x for x in spec['parts']}
    for ref,mpn in {'U130':'MSPM0L1106TRHBR','U131':'TPS70933DBVR','U132':'TPSM53603RDAR','U133':'TPS22953DQCR','J130':'1803277','F130':'0466004.NRHF'}.items():
        _require_hardware((meta[ref]['mpn']==mpn and not fps[ref].IsDNP()), lambda: (ref))
    for ref,value in {'C143':'470n','R130':'10k','R131':'2.43k','R135':'1M','R136':'150k'}.items():_require_hardware((fps[ref].GetValue()==value), lambda: (ref))
    _require_hardware((fps['J130'].GetOrientationDegrees()%360==180 and not fps['J130'].IsFlipped()), lambda: ('pi_power_checks.py:81: hardware validation condition'))
    pads={q.GetNumber():q for q in fps['U133'].Pads() if q.GetNumber()}
    _require_hardware((abs(p.ToMM(pads['11'].GetSize().x)-.84)<.001 and abs(p.ToMM(pads['11'].GetSize().y)-2.4)<.001), lambda: ('pi_power_checks.py:83: hardware validation condition'))
    from copper_resistance import pi_loop
    copper=pi_loop(board,board.GetFileName())
    b=budget(copper_ohm=copper['copper_with_reserve_ohm']+.015)
    _require_hardware((b['minimum_V']>4.75 and b['maximum_V']<5.25 and b['adc_at_18V']<2.5), lambda: (b))
    return dict(pin_checks=checks,deliberate_no_connects=len(NC),spare_bcm=[],budget=b,
                copper_extraction=copper,contact_allocation_ohm=.015,diode_spreader=diode_spreader(board),
                firmware='prototype implemented; battery policy disabled pending qualification',physical_qualification=False)
