naturalhazardscience/groundlark/sw/pi/groundlark/simulation.py

"""Deterministic device models, not electrical or instruction-set emulation."""
from .sensors import NotReady
from .stimulus import Scenario, reading
from .skylark import defaults as skylark_defaults
from .burrowlark import SETTINGS as CLIMATE_SETTINGS


class Simulated:
    def __init__(self, sensor, seed=1, faults=(), scenario=None, clock=None):
        if type(sensor) is not int or not 1 <= sensor <= 20: raise ValueError("simulated sensor ID")
        if type(seed) is not int or not 0 <= seed < 1 << 64: raise ValueError("seed must be uint64")
        self.sensor, self.seed, self.index = sensor, seed, 0
        self.scenario, self.clock = scenario or Scenario(), clock
        self.settings = next(c for c in defaults(legacy_gnss=True) + defaults(True) + defaults() + skylark_defaults() if c["sensor_id"] == sensor)
        if len(faults) > 256: raise ValueError("fault fixture bound")
        self.faults = {}
        for f in faults:
            if set(f) != {"sensor", "sample", "action"} or f["sensor"] not in range(1, 21) or type(f["sample"]) is not int or not 0 <= f["sample"] <= 1_000_000:
                raise ValueError("fault fixture fields")
            if f["action"] not in ("timeout", "nack", "disconnect", "not_ready", "saturation", "short_read"):
                raise ValueError("unknown fault action")
            if f["sensor"] == sensor:
                if f["sample"] in self.faults: raise ValueError("duplicate fault")
                self.faults[f["sample"]] = f["action"]

    def configure(self, settings):
        self.settings = dict(settings)
        return dict(settings)
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
