naturalhazardscience/groundlark/(commit log)

2026-10-12 Implement Burrowlark B1 four-sensor magnetic array
    Use four aligned RM3100 modules on a 30 mm grid with a common SPI trigger, independent data/DRDY lanes and preserved raw cohort timing. Add explicit calibrated averaging, quartet backpressure handling, firmware fault fixtures and the matching workbench/README model.
    Keep physical USB, timing, cross-talk and noise qualification explicit. The full-suite DAQHAT assembly failures are reproduced on the unchanged baseline.
    [01-usb-power-page-01.kicad_sch, 02-controller-page-01.kicad_sch, 03-magnetometer-0-page-01.kicad_sch, 03-magnetometer-1-page-01.kicad_sch, 03-magnetometer-2-page-01.kicad_sch, 03-magnetometer-3-page-01.kicad_sch, 03-sensors-page-01.kicad_sch, bom.csv]
2026-10-19 Update DAQHAT pressure sensor and assembly sourcing
    Replace D90 with TPD2E2U06QDCKRQ1 and redesign U23 around SDP32-125PA. Synchronize routed CAD, native SES, models, supplier records, acquisition drivers, contracts, simulations, tests and documentation.
    Record dated stock checks for 71 catalog identities and preserve the release gate for 52 unverified supplier placements. Generated manufacturing packages remain local and ignored.
    Validation: repository structure and diff checks pass; prior full lab run passed 25 of 26 stages, with 301 software tests and 221 of 222 hardware tests passing. The remaining hardware test blocks unverified placements. Browser interaction and physical qualificati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
    [03-geophone-page-01.kicad_sch, 05-fpga-interface-page-01.kicad_sch, 10-infrasound-page-01.kicad_sch, bom.csv, groundlark-daqhat-01.kicad_pcb, groundlark-daqhat-01.kicad_sch, pi-trenz-stack-concept.kicad_pcb, stack-exploded.kicad_pcb]
2026-10-20 Strengthen DAQHAT power copper and validate native layout
    Extend Pi supply pours to J1, add output via arrays and an FPGA distribution
    bridge, spread D130 heat, correct GNSS RF width, and add UART idle bias.
    Synchronize circuit, native CAD, schematic, SES, models and assembly mapping.
    Extract native DC resistance, screen adjacent-layer coupling, preserve checks
    under Python optimization, and disable I2C/I3C on the shared SPI IMUs.
    Refresh specifications, supplier identity records and validation evidence.
    Native ERC/DRC, route replay, simulations and 302 software tests pass. The final
    hardware run passes 234/235; 52 supplier placement holds still prevent release.
    All 71 exact catalog identi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
    [07-fpga-host-isolation-page-02.kicad_sch, bom.csv, groundlark-daqhat-01.kicad_pcb, groundlark-daqhat-01.kicad_sch, pi-trenz-stack-concept.kicad_pcb, stack-exploded.kicad_pcb, stack-service-envelopes.kicad_pcb, trenz-mounted.kicad_pcb]
2026-10-20 Average SDP32 readings for landslide research and tighten qualification checks
    Use differential-pressure average-until-read at 100 Hz for a researched 1-20 Hz
    target. Preserve raw frames and optional averaging interval bounds, discard
    uncertain/late windows with DataGap, and recover without resetting healthy buses.
    Add sub-pascal tone, alias, CRC, worker IPC and legacy recording regressions.
    Document Trenz CPLD REV03's MODE pull-up and audit unloaded MODE, NOSEQ bias and
    EN1 inhibit. Require pressure, RF and bus evidence in physical bench report v4,
    correct the FPGA hot-loop limit, and refresh stale documentation.
    Validation: 314 software tests passed; 235/236 hardware tests passed. The so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
    [bench.py, gpio_audit.py, hat_signals.py, lab.py, measurements.py, pressure.py, pressure_response.py]
2026-10-20 Add geometry-based simulations and 200 Hz pressure acquisition
2026-10-20 Fix GNSS RF margin and broaden pressure filter robustness
    [04-gnss-page-01.kicad_sch, 04-gnss-page-02.kicad_sch, Coilcraft_0402HP_envelope.step, bom.csv, groundlark-daqhat-01.kicad_pcb, pi-trenz-stack-concept.kicad_pcb, stack-exploded.kicad_pcb, stack-service-envelopes.kicad_pcb]
2026-10-20 Gate expanded coupling analysis and correct RF review evidence
    Include angled crossings and endpoint proximity, union overlapping intervals, and evaluate both aggressor directions against a 0.20 V allocation. Check the SMA return annulus, expose unreferenced branches, correct inductor defaults and scope labels, and retain RF tuning and D130 thermal qualifications.
    Validation: 267 hardware tests and 315 software tests pass; ERC/DRC are clean and SES replay matches. The simulation profile completes with 27/28 stages passing: 32 of 233 coupling pairs exceed the allocation (worst 0.736 V). Native PCB routing is unchanged and fabrication remains blocked.
    [gnss_checks.py, layer_coupling.py, pi_power_checks.py, prefab_review.py, simulate_signal_integrity.py, test_coupling_gate.py, test_layer_coupling.py]
2026-10-20 Resolve adjacent-layer coupling gate with revised signal routing
    [groundlark-daqhat-01.kicad_pcb, pi-trenz-stack-concept.kicad_pcb, stack-exploded.kicad_pcb, stack-service-envelopes.kicad_pcb, trenz-mounted.kicad_pcb]
2026-10-20 Complete supplier pad registration and correct D140 lands
    [groundlark-daqhat-01.kicad_pcb, pi-trenz-stack-concept.kicad_pcb, stack-exploded.kicad_pcb, stack-service-envelopes.kicad_pcb, trenz-mounted.kicad_pcb, trenz_hat.kicad_pcb]
